bozotics/soccer2019/PCB/projects/maplemini/maplemini.png

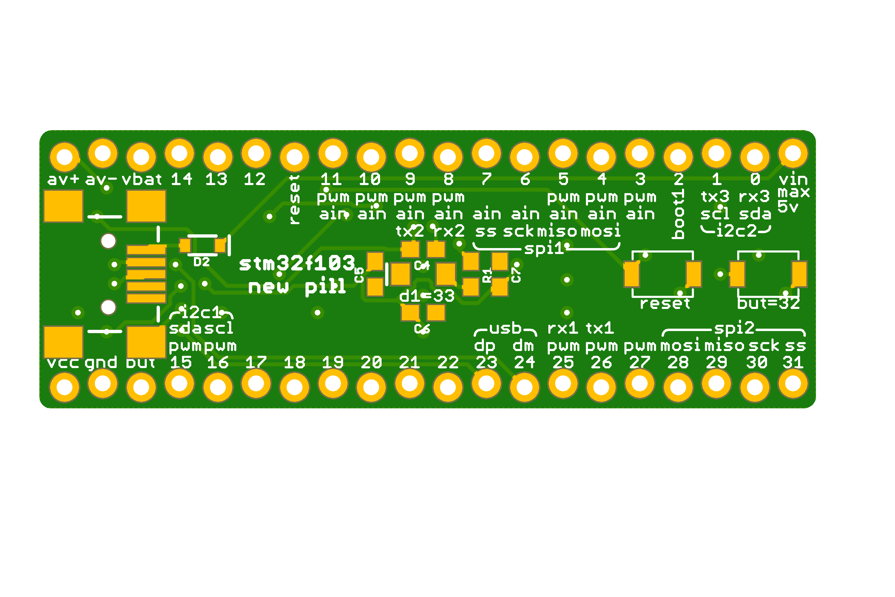
PCB/projects/maplemini/maplemini.png
