bozotics/soccer2019/PCB/projects/PCB2k19/PCB1.pdf

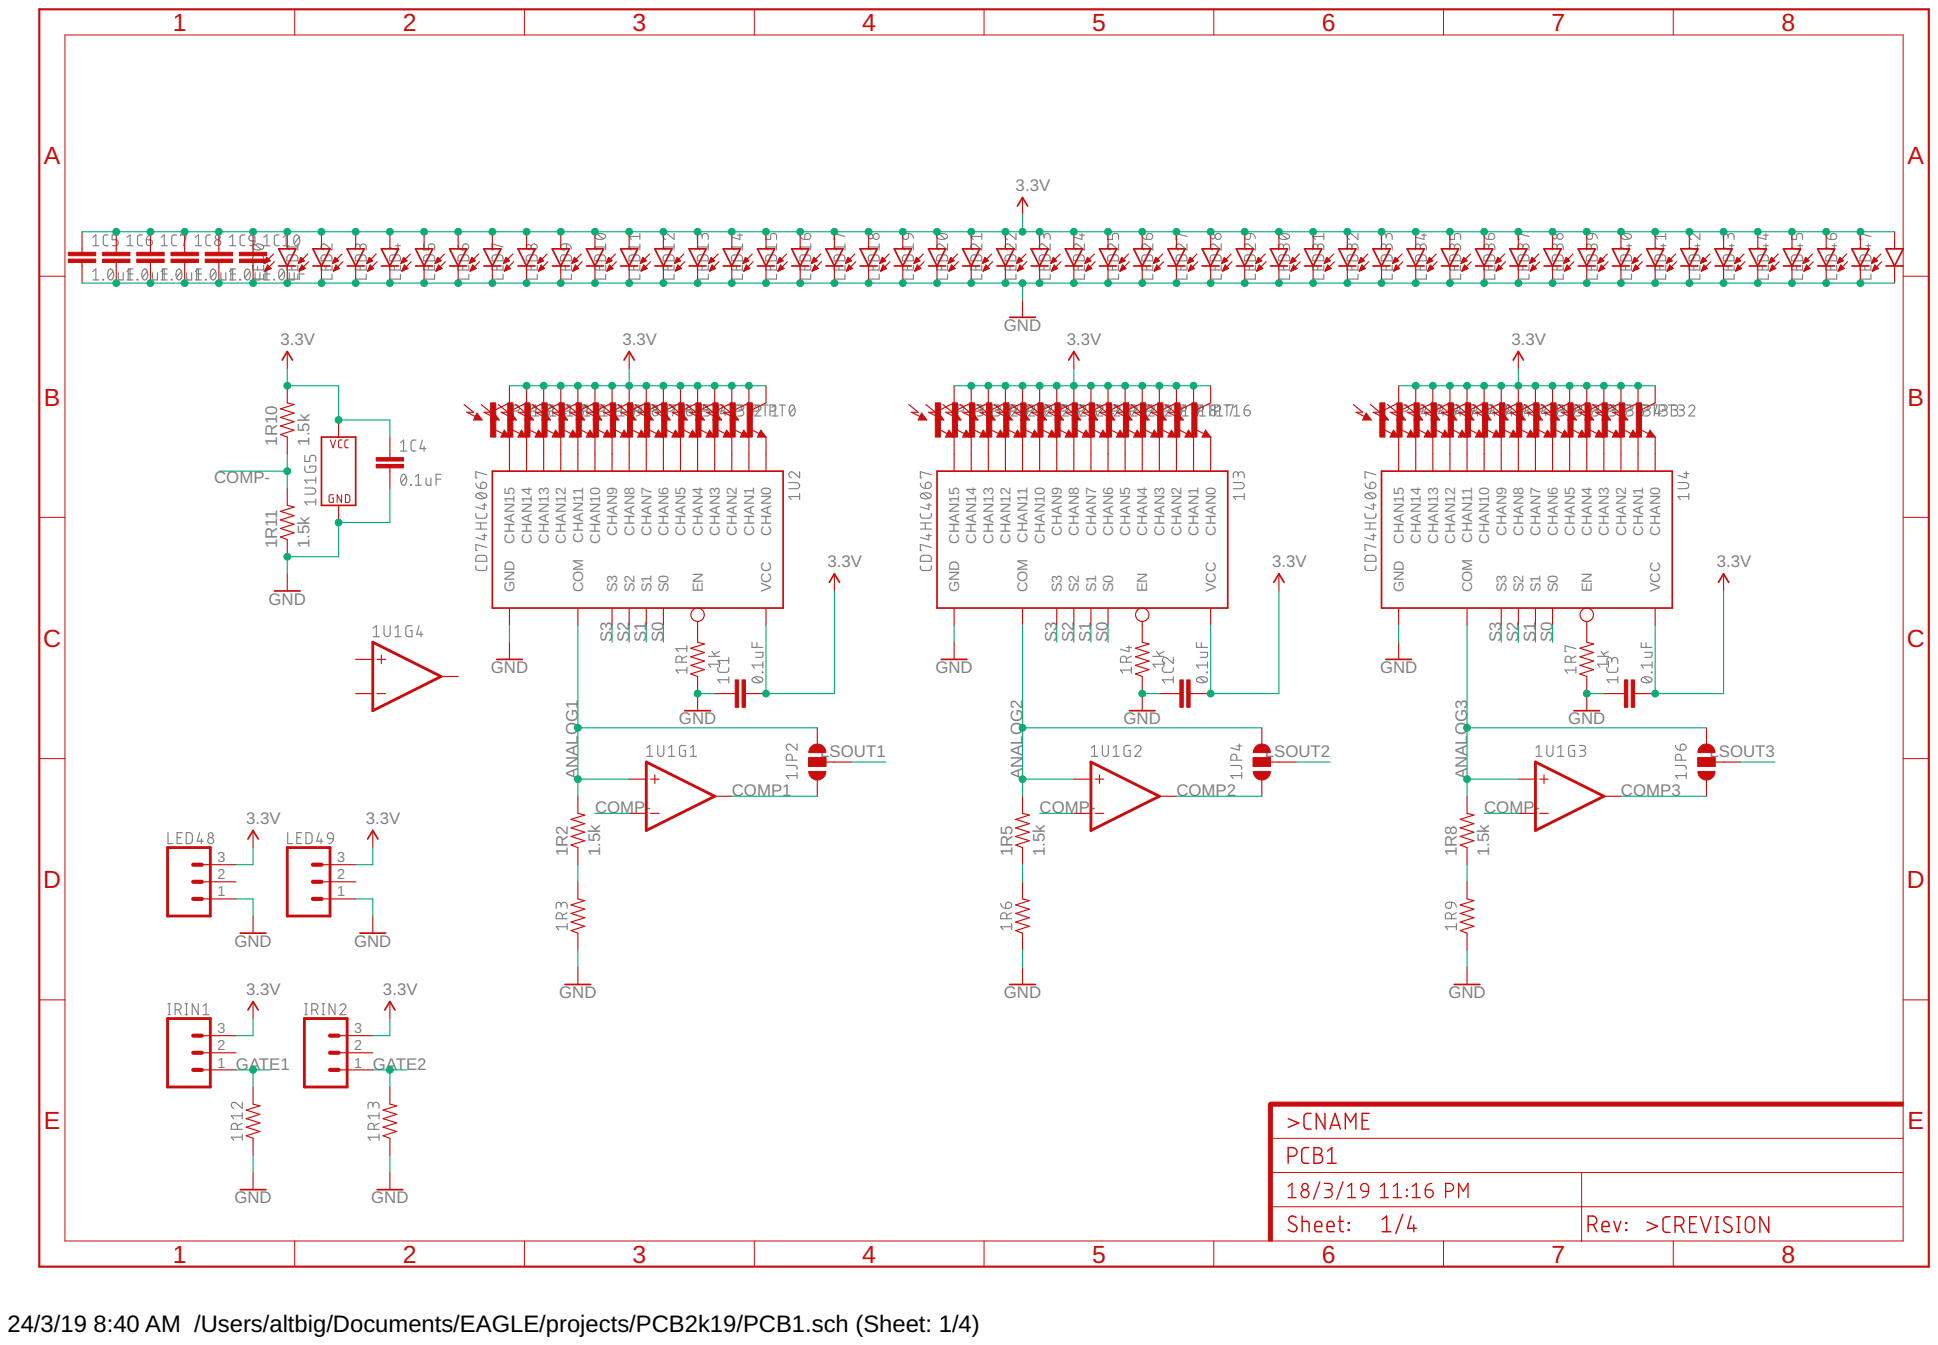
[picture p2: page 1]

24/3/19 8:40 AM /Users/altbig/Documents/EAGLE/projects/PCB2k19/PCB1.sch (Sheet: 1/4)

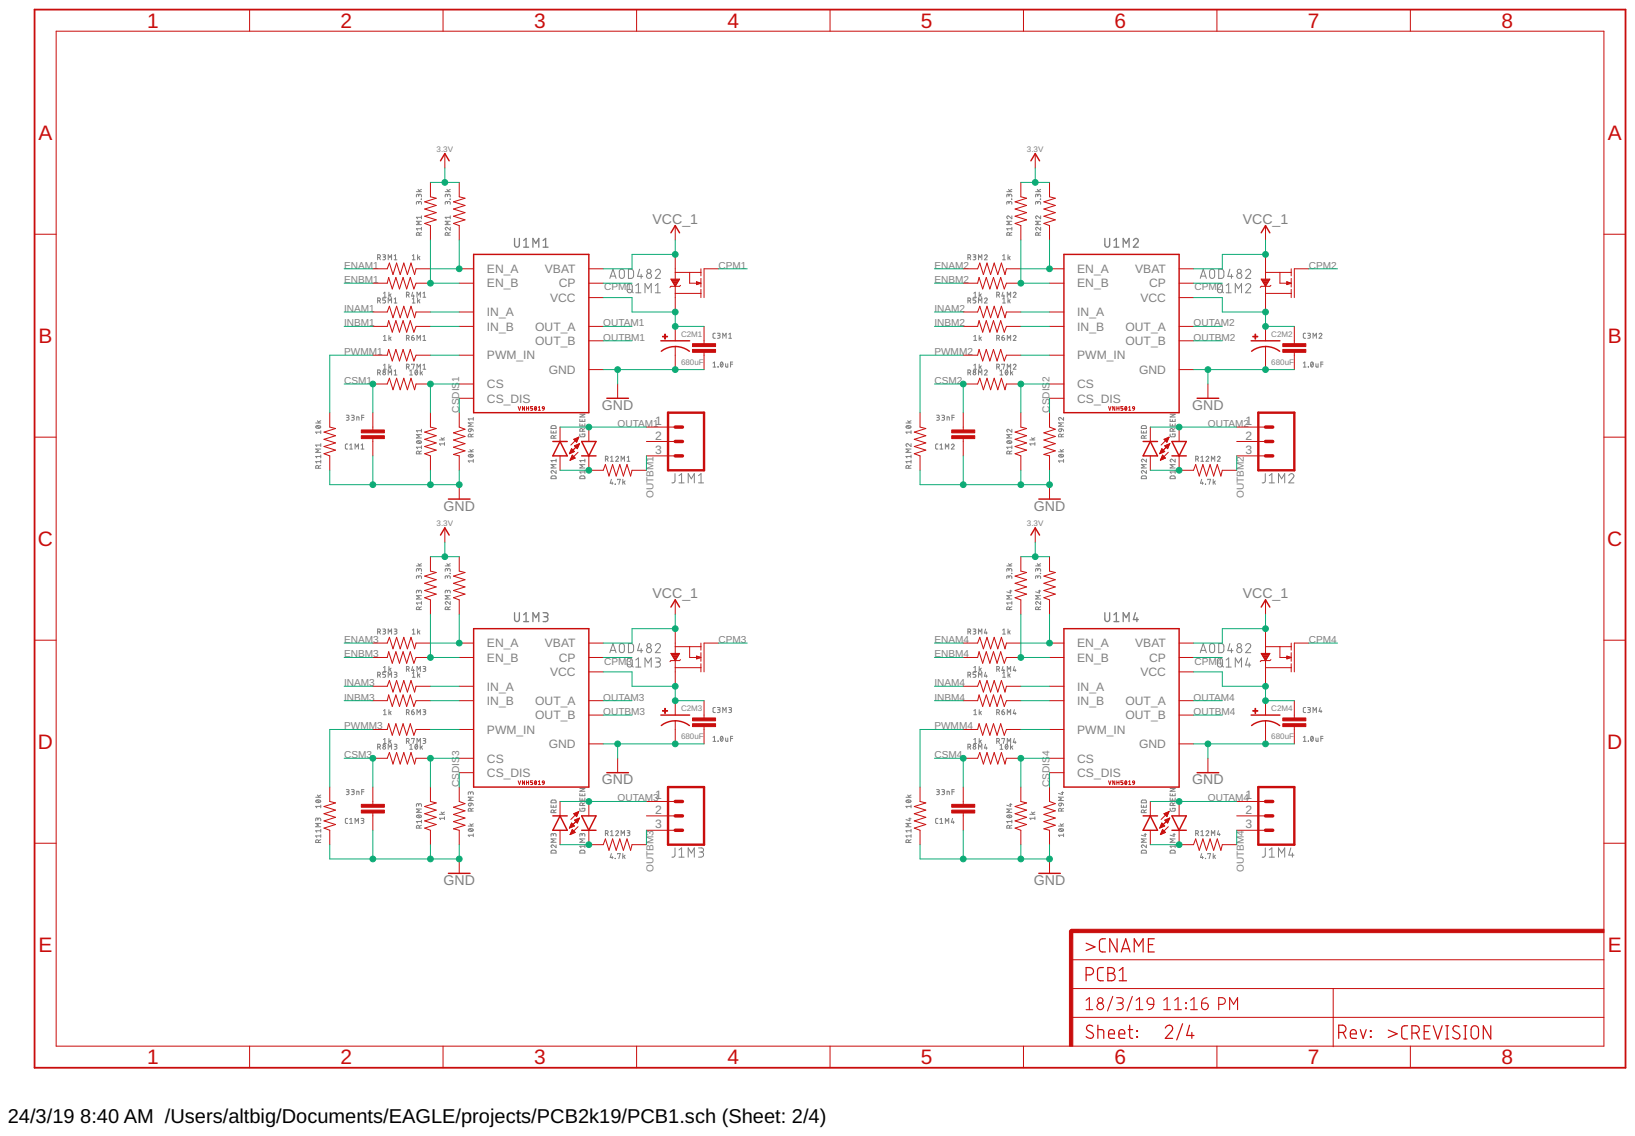
[picture p3: page 2]

24/3/19 8:40 AM /Users/altbig/Documents/EAGLE/projects/PCB2k19/PCB1.sch (Sheet: 2/4)

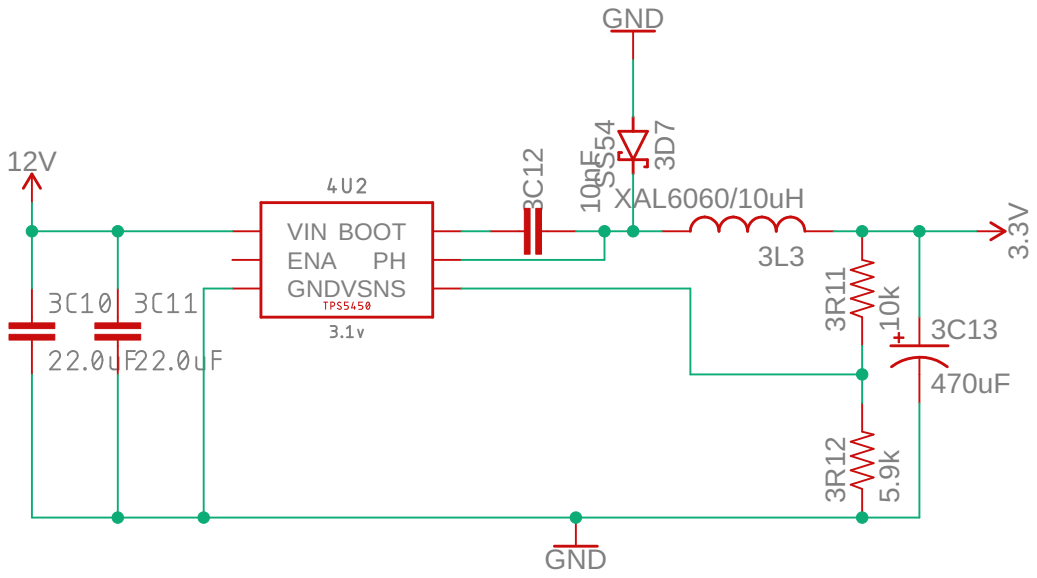
[picture p4: page 3]

24/3/19 8:40 AM /Users/altbig/Documents/EAGLE/projects/PCB2k19/PCB1.sch (Sheet: 3/4)

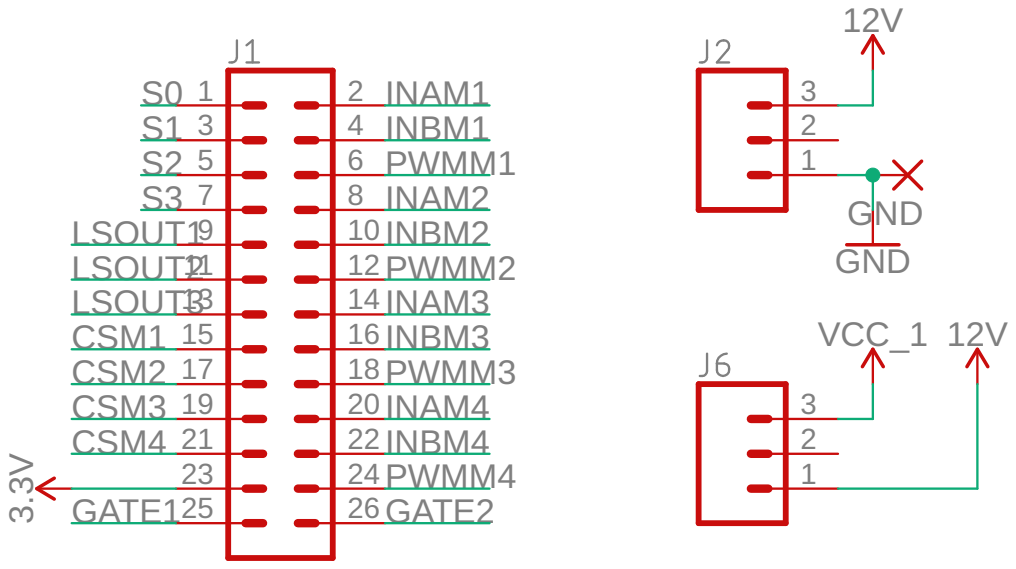
[picture p5: page 4]

24/3/19 8:40 AM /Users/altbig/Documents/EAGLE/projects/PCB2k19/PCB1.sch (Sheet: 4/4)
