bozotics/soccer2019/PCB/projects/PCB2k19/PCB2.pdf

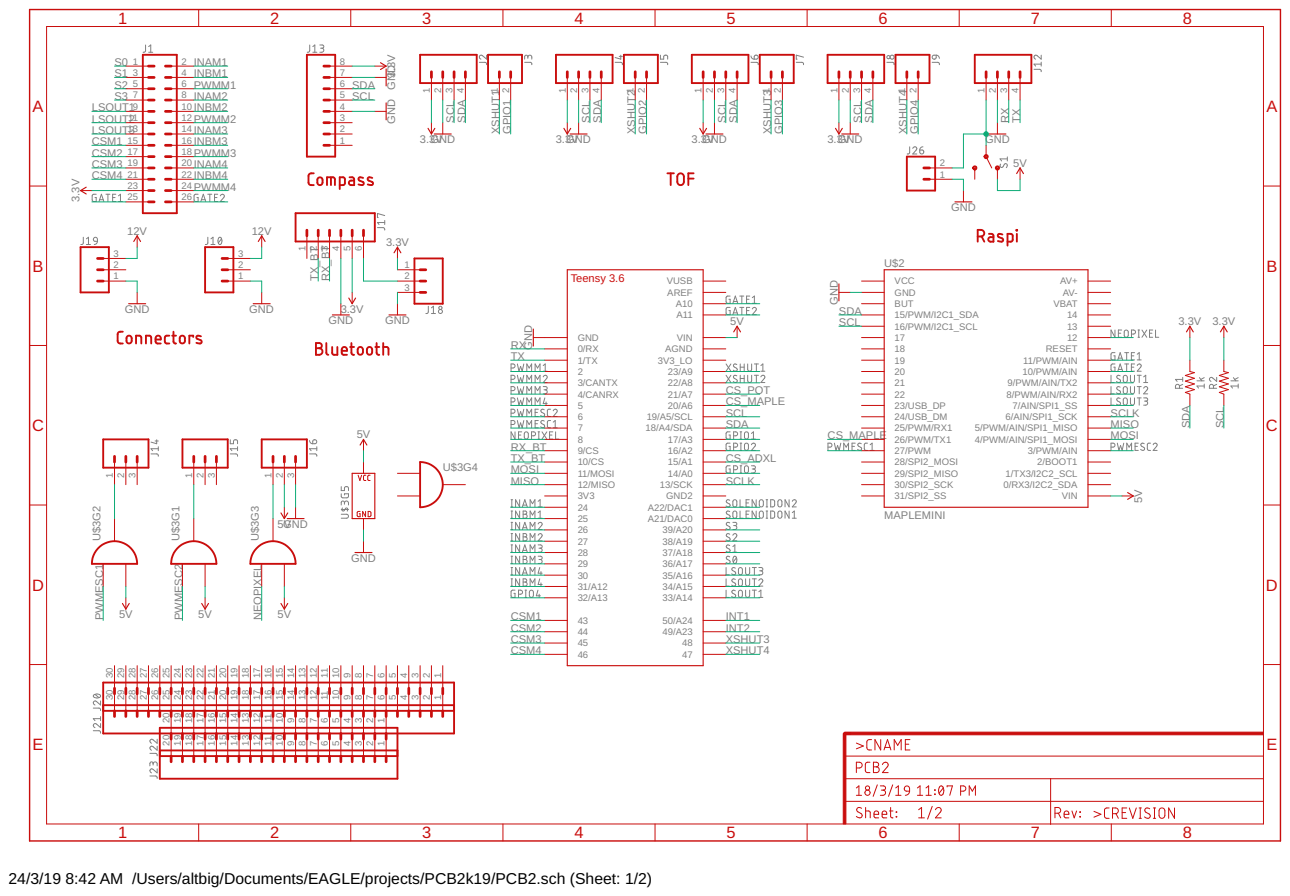
[picture p6: page 1]

11/PWM/AIN
10/PWM/AIN
9/PWM/AIN/TX2
8/PWM/AIN/RX2
7/AIN/SPI1_SS
6/AIN/SPI1_SCK
5/PWM/AIN/SPI1_MISO
4/PWM/AIN/SPI1_MOSI 3/PWM/AIN

24/3/19 8:42 AM /Users/altbig/Documents/EAGLE/projects/PCB2k19/PCB2.sch (Sheet: 1/2)

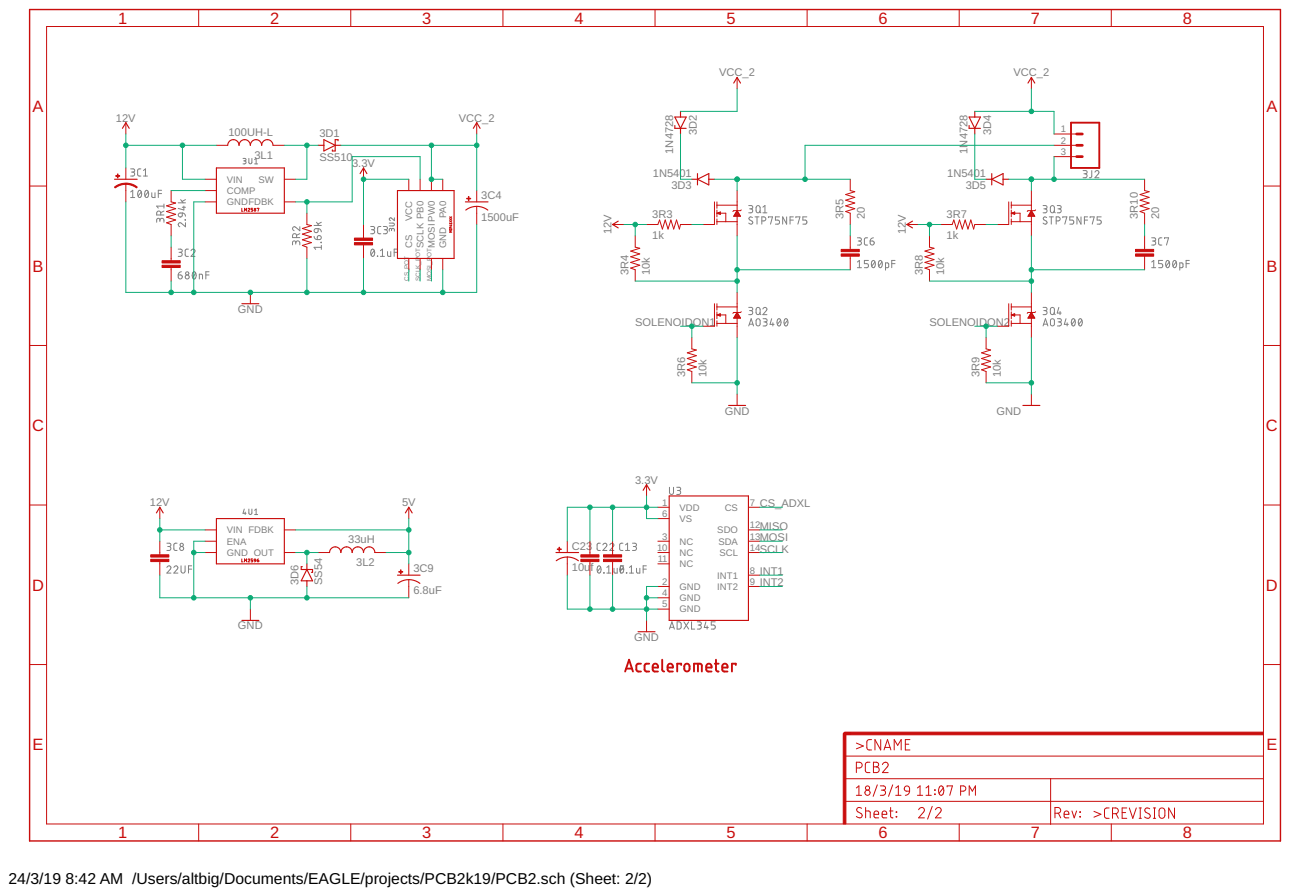
[picture p7: page 2]

SCLK MOSI GND PA0 PW0 PB0 VCC

ENA GND OUT VIN FDBK

24/3/19 8:42 AM /Users/altbig/Documents/EAGLE/projects/PCB2k19/PCB2.sch (Sheet: 2/2)
