bozotics/soccer2019/PCB/projects/maplemini/maplemini2layer.pdf

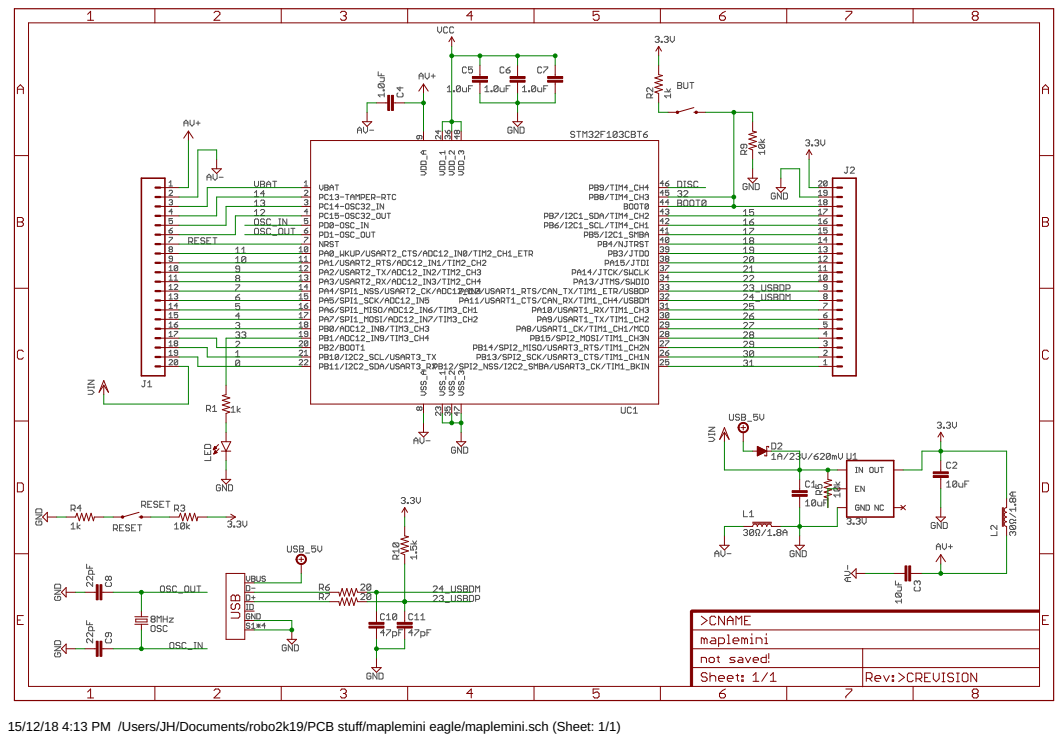
[picture p8: page 1]

15/12/18 4:13 PM /Users/JH/Documents/robo2k19/PCB stuff/maplemini eagle/maplemini.sch (Sheet: 1/1)
