bozotics/soccer2019/PCB/projects/PCB2k19/PCB2.brd

## EAGLE design PCB/projects/PCB2k19/PCB2.brd (2019-03-18)

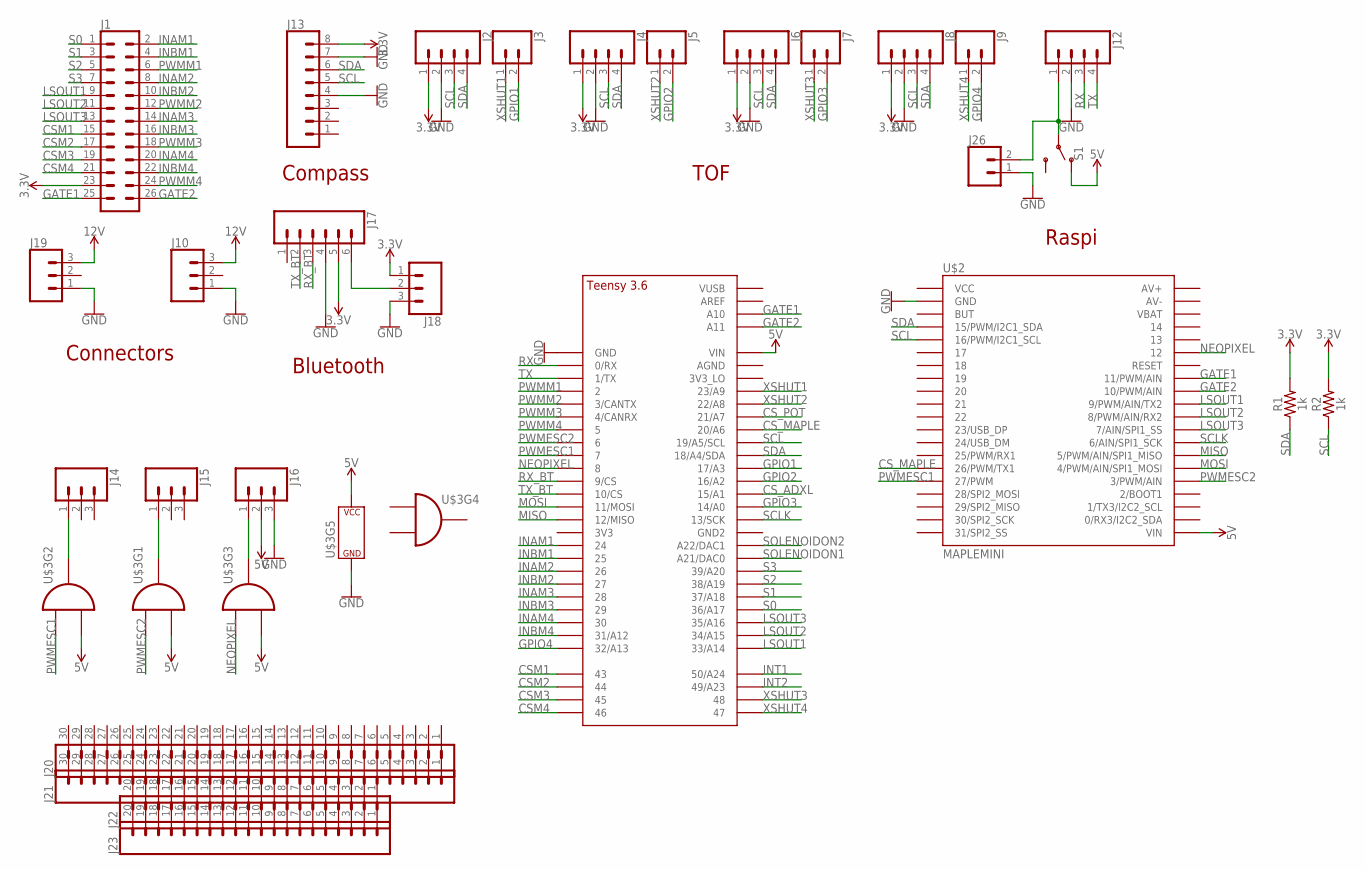
[picture p9: schematic PCB2.sch, sheet 1]

Parts:
J1: CONN_13X22X13; 2X13
J2, J4, J6, J8, J12: CONN_04LOCK; 1X04_LOCK
J3, J5, J7, J9, J26: CONN_02LOCK; 1X02_LOCK
J10, J19: CONN_03-SCREW-5MM; SCREWTERMINAL-5MM-3
J13: CONN_08LOCK; 1X08_LOCK
J14, J15, J16, J18: CONN_03LOCK; 1X03_LOCK
J17: CONN_06LOCK; 1X06_LOCK
J20, J21: CONN_30; 1X30
J22, J23: CONN_20; 1X20
R1, R2: 1k; 0603
S1: SWITCH-SPDT-PTH-11.6X4.0MM-LOCK; SWITCH_SPDT_PTH_11.6X4.0MM_LOCK
U$1: TEENSY_3.5/3.6_BASIC
U$2: MAPLEMINI; 20-DIP
U$3: 74HCT08; SOIC-14

Connections:
3.3V: J1.23, J2.1, J4.1, J6.1, J8.1, J13.8, J17.5, J18.1, R1.2, R2.2; also elsewhere on the board
5V: J16.2, S1.1 (O), U$1.VIN, U$2.21 (VIN), U$3.P2 (I1), U$3.P5 (I1), U$3.P10 (I1), U$3.P14 (P$V+); also elsewhere on the board
12V: J10.3, J19.3; also elsewhere on the board
CSM1: J1.15, U$1.43
CSM2: J1.17, U$1.44
CSM3: J1.19, U$1.45
CSM4: J1.21, U$1.46
CS_ADXL: U$1.15/A1; also elsewhere on the board
CS_MAPLE: U$1.20/A6, U$2.15 (26/PWM/TX1)
CS_POT: U$1.21/A7; also elsewhere on the board
GATE1: J1.25, U$1.A10, U$2.33 (11/PWM/AIN)
GATE2: J1.26, U$1.A11, U$2.32 (10/PWM/AIN)
GND: J2.2, J4.2, J6.2, J8.2, J10.1, J12.2, J13.4, J13.7, J16.3, J17.4, J18.3, J19.1, J26.1, U$1.GND, U$2.2 (GND), U$3.P7 (P$V-); also elsewhere on the board
GPIO1: J3.2, U$1.17/A3
GPIO2: J5.2, U$1.16/A2
GPIO3: J7.2, U$1.14/A0
GPIO4: J9.2, U$1.32/A13
INAM1: J1.2, U$1.24
INAM2: J1.8, U$1.26
INAM3: J1.14, U$1.28
INAM4: J1.20, U$1.30
INBM1: J1.4, U$1.25
INBM2: J1.10, U$1.27
INBM3: J1.16, U$1.29
INBM4: J1.22, U$1.31/A12
INT1: U$1.50/A24; also elsewhere on the board
INT2: U$1.49/A23; also elsewhere on the board
LSOUT1: J1.9, U$1.33/A14, U$2.31 (9/PWM/AIN/TX2)
LSOUT2: J1.11, U$1.34/A15, U$2.30 (8/PWM/AIN/RX2)
LSOUT3: J1.13, U$1.35/A16, U$2.29 (7/AIN/SPI1_SS)
MISO: U$1.12/MISO, U$2.27 (5/PWM/AIN/SPI1_MISO); also elsewhere on the board
MOSI: U$1.11/MOSI, U$2.26 (4/PWM/AIN/SPI1_MOSI); also elsewhere on the board
unnamed: J12.1, J26.2, S1.2
unnamed: J16.1, U$3.P8 (O)
unnamed: J14.1, U$3.P6 (O)
unnamed: J15.1, U$3.P3 (O)
unnamed: J17.6, J18.2
NEOPIXEL: U$1.8, U$2.35 (12), U$3.P9 (I0)
PWMESC1: U$1.7, U$2.16 (27/PWM), U$3.P4 (I0)
PWMESC2: U$1.6, U$2.25 (3/PWM/AIN), U$3.P1 (I0)
PWMM1: J1.6, U$1.2
PWMM2: J1.12, U$1.3/CANTX
PWMM3: J1.18, U$1.4/CANRX
PWMM4: J1.24, U$1.5
RX: J12.3, U$1.0/RX
RX_BT: J17.3, U$1.9/CS
S0: J1.1, U$1.36/A17
S1: J1.3, U$1.37/A18
S2: J1.5, U$1.38/A19
S3: J1.7, U$1.39/A20
SCL: J2.3, J4.3, J6.3, J8.3, J13.5, R2.1, U$1.19/A5/SCL, U$2.5 (16/PWM/I2C1_SCL)
SCLK: U$1.13/SCK, U$2.28 (6/AIN/SPI1_SCK); also elsewhere on the board
SDA: J2.4, J4.4, J6.4, J8.4, J13.6, R1.1, U$1.18/A4/SDA, U$2.4 (15/PWM/I2C1_SDA)
SOLENOIDON1: U$1.21/DAC0 (A21/DAC0); also elsewhere on the board
SOLENOIDON2: U$1.A22/DAC1; also elsewhere on the board
TX: J12.4, U$1.1/TX
TX_BT: J17.2, U$1.10/CS
XSHUT1: J3.1, U$1.23/A9
XSHUT2: J5.1, U$1.22/A8
XSHUT3: J7.1, U$1.48
XSHUT4: J9.1, U$1.47

Notes on the sheet:
Raspi
TOF
Compass
Connectors
Bluetooth

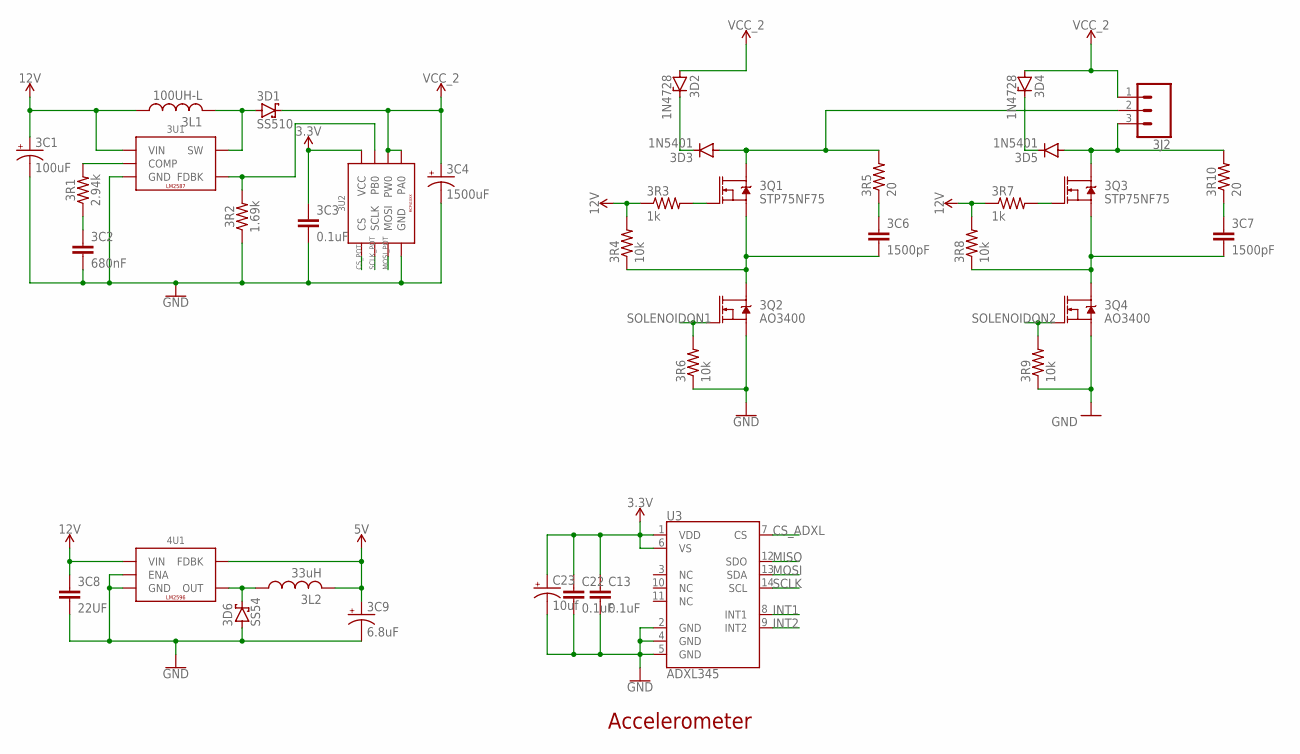
[picture p10: schematic PCB2.sch, sheet 2]

Parts:
3C1: 100uF; PANASONIC_D
3C2: 680nF; 0603
3C3: 0.1uF; 0603
3C4: 1500uF; 1000UF-CAP
3C6, 3C7: 1500pF; 0603
3C8: 22UF; 1210
3C9: 6.8uF; A/3216-18R
3D1: SS510; SMB
3D2, 3D4: 1N4728; DO41Z10
3D3, 3D5: 1N5401; DO201-15
3D6: SS54; SMB
3J2: CONN_03-SCREW-5MM; SCREWTERMINAL-5MM-3
3L1: 100UH-L
3L2: 33uH; 127
3Q1, 3Q3: STP75NF75; TO220V
3Q2, 3Q4: AO3400; SOT23-3
3R1: 2.94k; 0603
3R2: 1.69k; 0603
3R3, 3R7: 1k; 0603
3R4, 3R6, 3R8, 3R9: 10k; 0603
3R5, 3R10: 20; 0603
3U1: LM2587; TO-263
3U2: MCP41XXX; SOIC-8
4U1: LM2596; TO-263
C13, C22: 0.1uF; 0603
C23: 10uf; R/2012-12R
U3: ADXL345; LGA-14

Connections:
3.3V: 3C3.1, 3U2.8 (VCC), C13.1, C22.1, C23.+, U3.1 (VDD), U3.6 (VS); also elsewhere on the board
5V: 3C9.+, 3L2.2, 4U1.P4 (FDBK); also elsewhere on the board
12V: 3C1.+, 3C8.1, 3L1.P1 (1), 3R3.1, 3R4.2, 3R7.1, 3R8.2, 3U1.P5 (VIN), 4U1.P1 (VIN); also elsewhere on the board
CS_ADXL: U3.7 (CS); also elsewhere on the board
CS_POT: 3U2.1 (CS); also elsewhere on the board
GND: 3C1.-, 3C2.2, 3C3.2, 3C4.-, 3C8.2, 3C9.-, 3D6.A, 3Q2.2 (S), 3Q4.2 (S), 3R2.1, 3R6.1, 3R9.1, 3U1.P3 (GND), 3U2.4 (GND), 4U1.P3 (GND), 4U1.P5 (ENA), 4U1.TAB (GND), C13.2, C22.2, C23.-, U3.2 (GND), U3.4 (GND), U3.5 (GND); also elsewhere on the board
INT1: U3.8 (INT1); also elsewhere on the board
INT2: U3.9 (INT2); also elsewhere on the board
MISO: U3.12 (SDO); also elsewhere on the board
MOSI: U3.13 (SDA); also elsewhere on the board
MOSI_POT: 3U2.3 (MOSI)
unnamed: 3D1.A, 3L1.P2 (2), 3U1.P4 (SW)
unnamed: 3C6.2, 3Q1.3 (S), 3Q2.3 (D), 3R4.1
unnamed: 3R1.2, 3U1.P1 (COMP)
unnamed: 3C2.1, 3R1.1
unnamed: 3Q1.1 (G), 3R3.2
unnamed: 3D2.C, 3D3.C
unnamed: 3C6.1, 3R5.1
unnamed: 3C7.2, 3Q3.3 (S), 3Q4.3 (D), 3R8.1
unnamed: 3Q3.1 (G), 3R7.2
unnamed: 3D4.C, 3D5.C
unnamed: 3C7.1, 3R10.1
unnamed: 3D6.C, 3L2.1, 4U1.P2 (OUT)
unnamed: 3R2.2, 3U1.P2 (FDBK), 3U2.7 (PB0)
SCLK: U3.14 (SCL); also elsewhere on the board
SCLK_POT: 3U2.2 (SCLK)
SOLENOID-: 3D3.A, 3J2.2, 3Q1.2 (D), 3R5.2
SOLENOID-1: 3D5.A, 3J2.3, 3Q3.2 (D), 3R10.2
SOLENOIDON1: 3Q2.1 (G), 3R6.2; also elsewhere on the board
SOLENOIDON2: 3Q4.1 (G), 3R9.2; also elsewhere on the board
VCC_2: 3C4.+, 3D1.C, 3D2.A, 3D4.A, 3J2.1, 3U2.5 (PA0), 3U2.6 (PW0)

Notes on the sheet:
Accelerometer

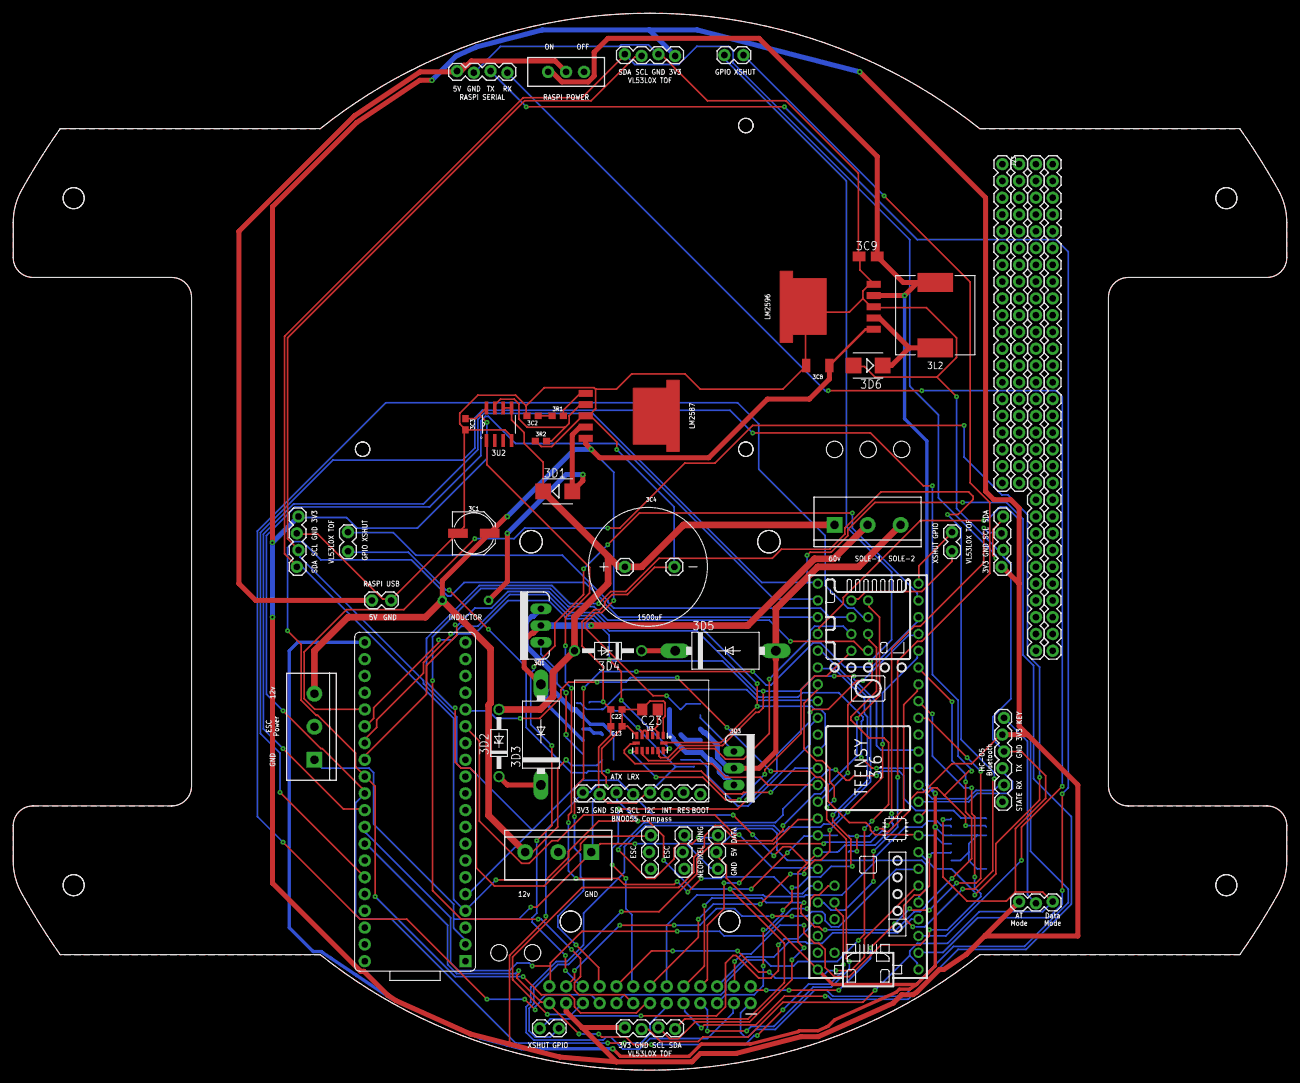
[picture p11: board PCB2.brd from above]

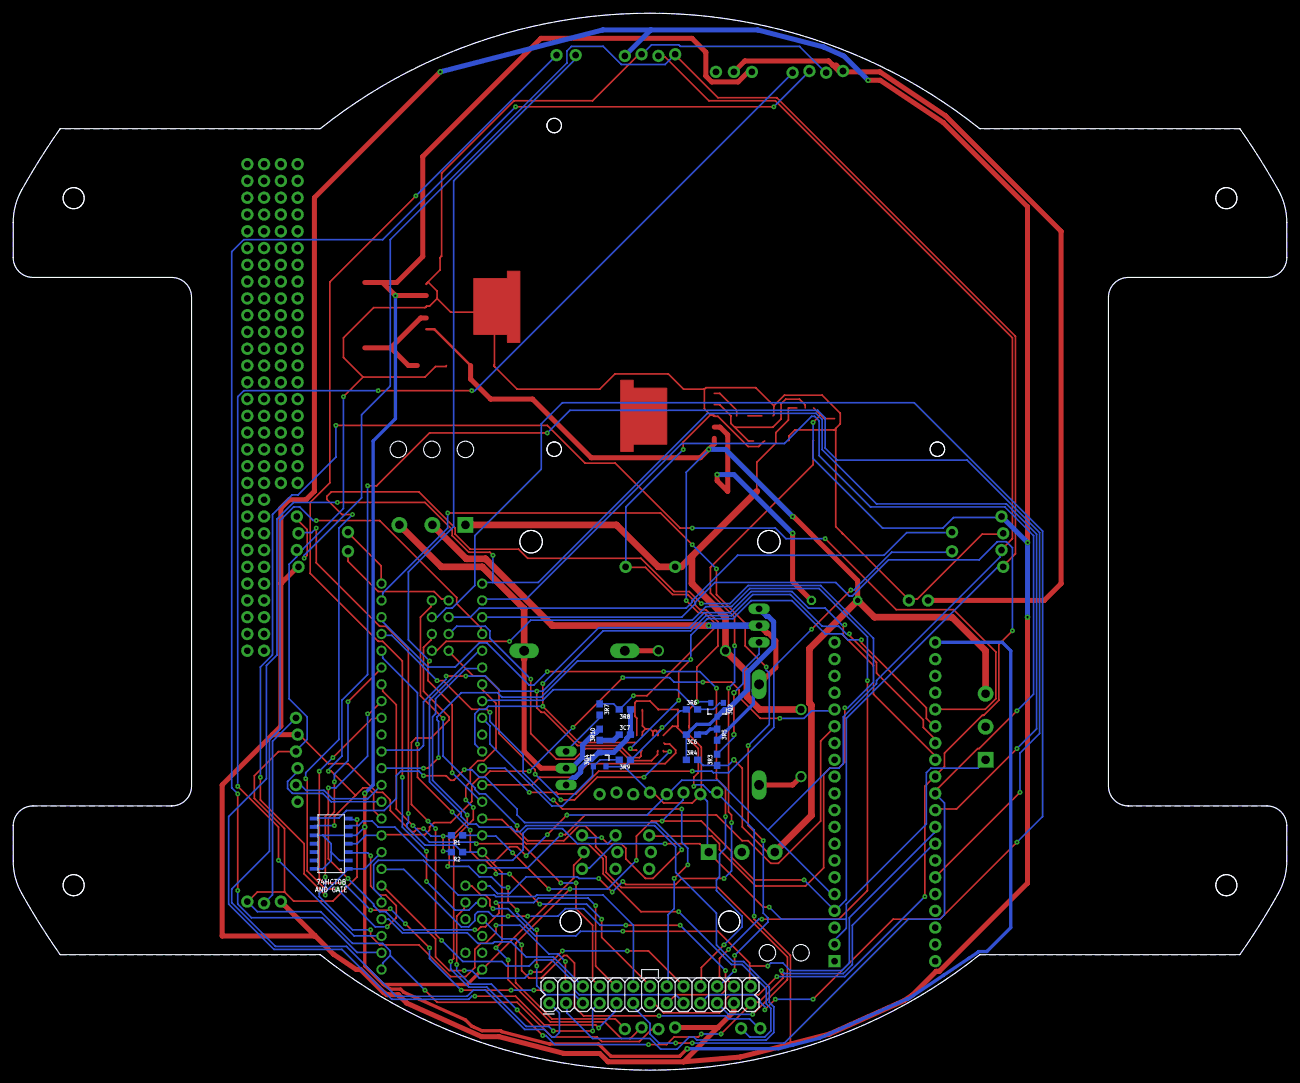
[picture p12: board PCB2.brd from below]

Board: 2 copper layers, 192.8 x 160.0 mm, 67 parts (16 on the bottom side), 77 nets.
