bozotics/soccer2019/PCB/projects/PCB2k19/PCB1.brd

## EAGLE design PCB/projects/PCB2k19/PCB1.brd (2019-03-18)

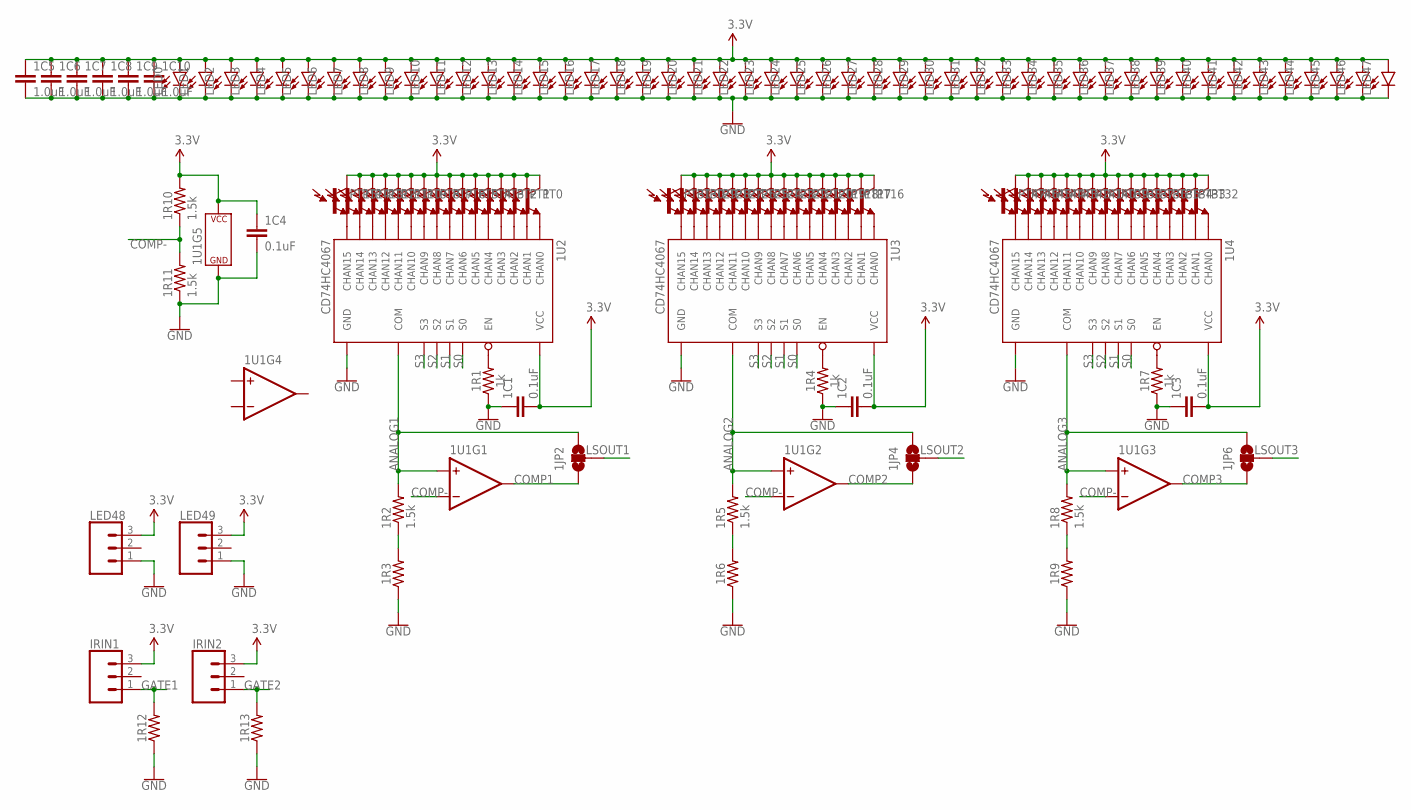
[picture p13: schematic PCB1.sch, sheet 1, Light Sensor]

Parts:
1C1, 1C2, 1C3, 1C4: 0.1uF; 0603
1C5, 1C6, 1C7, 1C8, 1C9, 1C10: 1.0uF; 0603
1JP2, 1JP4, 1JP6: JUMPER-SMT_3_NO_NO_SILK; SMT-JUMPER_3_0-NO_TRACE_NO-SILK
1R1, 1R4, 1R7: 1k; 0603
1R2, 1R5, 1R8, 1R10, 1R11: 1.5k; 0603
1R3, 1R6, 1R9, 1R12, 1R13: 0603
1U1: LM339; SOIC-14
1U2, 1U3, 1U4: CD74HC4067; SOIC-24
IRIN1, IRIN2: CONN_03; 1X03
LED0, LED1, LED2, LED3, LED4, LED5, LED6, LED7, LED8, LED9, LED10, LED11, LED12, LED13, LED14, LED15, LED16, LED17, LED18, LED19, LED20, LED21, LED22, LED23, LED24, LED25, LED26, LED27, LED28, LED29, LED30, LED31, LED32, LED33, LED34, LED35, LED36, LED37, LED38, LED39, LED40, LED41, LED42, LED43, LED44, LED45, LED46, LED47: 3528LED; 3528
LED48, LED49: CONN_03; 1X03
PT0, PT1, PT2, PT3, PT4, PT5, PT6, PT7, PT8, PT9, PT10, PT11, PT12, PT13, PT14, PT15, PT16, PT17, PT18, PT19, PT20, PT21, PT22, PT23, PT24, PT25, PT26, PT27, PT28, PT29, PT30, PT31, PT32, PT33, PT34, PT35, PT36, PT37, PT38, PT39, PT40, PT41, PT42, PT43, PT44, PT45, PT46, PT47: TEMT6000

Connections:
3.3V: 1C1.2, 1C2.2, 1C3.2, 1C4.1, 1C5.1, 1C6.1, 1C7.1, 1C8.1, 1C9.1, 1C10.1, 1R10.2, 1U1.P3 (P$V+), 1U2.P24 (VCC), 1U3.P24 (VCC), 1U4.P24 (VCC), IRIN1.3, IRIN2.3, LED0.A, LED1.A, LED2.A, LED3.A, LED4.A, LED5.A, LED6.A, LED7.A, LED8.A, LED9.A, LED10.A, LED11.A, LED12.A, LED13.A, LED14.A, LED15.A, LED16.A, LED17.A, LED18.A, LED19.A, LED20.A, LED21.A, LED22.A, LED23.A, LED24.A, LED25.A, LED26.A, LED27.A, LED28.A, LED29.A, LED30.A, LED31.A, LED32.A, LED33.A, LED34.A, LED35.A, LED36.A, LED37.A, LED38.A, LED39.A, LED40.A, LED41.A, LED42.A, LED43.A, LED44.A, LED45.A, LED46.A, LED47.A, LED48.3, LED49.3, PT0.COLLECTOR (C1), PT1.COLLECTOR (C1), PT2.COLLECTOR (C1), PT3.COLLECTOR (C1), PT4.COLLECTOR (C1), PT5.COLLECTOR (C1), PT6.COLLECTOR (C1), PT7.COLLECTOR (C1), PT8.COLLECTOR (C1), PT9.COLLECTOR (C1), PT10.COLLECTOR (C1), PT11.COLLECTOR (C1), PT12.COLLECTOR (C1), PT13.COLLECTOR (C1), PT14.COLLECTOR (C1), PT15.COLLECTOR (C1), PT16.COLLECTOR (C1), PT17.COLLECTOR (C1), PT18.COLLECTOR (C1), PT19.COLLECTOR (C1), PT20.COLLECTOR (C1), PT21.COLLECTOR (C1), PT22.COLLECTOR (C1), PT23.COLLECTOR (C1), PT24.COLLECTOR (C1), PT25.COLLECTOR (C1), PT26.COLLECTOR (C1), PT27.COLLECTOR (C1), PT28.COLLECTOR (C1), PT29.COLLECTOR (C1), PT30.COLLECTOR (C1), PT31.COLLECTOR (C1), PT32.COLLECTOR (C1), PT33.COLLECTOR (C1), PT34.COLLECTOR (C1), PT35.COLLECTOR (C1), PT36.COLLECTOR (C1), PT37.COLLECTOR (C1), PT38.COLLECTOR (C1), PT39.COLLECTOR (C1), PT40.COLLECTOR (C1), PT41.COLLECTOR (C1), PT42.COLLECTOR (C1), PT43.COLLECTOR (C1), PT44.COLLECTOR (C1), PT45.COLLECTOR (C1), PT46.COLLECTOR (C1), PT47.COLLECTOR (C1); also elsewhere on the board
ANALOG1: 1JP2.3, 1R2.2, 1U1.P5 (+IN), 1U2.P1 (COM)
ANALOG2: 1JP4.3, 1R5.2, 1U1.P7 (+IN), 1U3.P1 (COM)
ANALOG3: 1JP6.3, 1R8.2, 1U1.P9 (+IN), 1U4.P1 (COM)
COMP1: 1JP2.1, 1U1.P2 (OUT)
COMP2: 1JP4.1, 1U1.P1 (OUT)
COMP3: 1JP6.1, 1U1.P14 (OUT)
COMP-: 1R10.1, 1R11.2, 1U1.P4 (-IN), 1U1.P6 (-IN), 1U1.P8 (-IN)
GATE1: 1R12.2, IRIN1.1; also elsewhere on the board
GATE2: 1R13.2, IRIN2.1; also elsewhere on the board
GND: 1C1.1, 1C2.1, 1C3.1, 1C4.2, 1C5.2, 1C6.2, 1C7.2, 1C8.2, 1C9.2, 1C10.2, 1R1.1, 1R3.1, 1R4.1, 1R6.1, 1R7.1, 1R9.1, 1R11.1, 1R12.1, 1R13.1, 1U1.P12 (P$V-), 1U2.P12 (GND), 1U3.P12 (GND), 1U4.P12 (GND), LED0.C, LED1.C, LED2.C, LED3.C, LED4.C, LED5.C, LED6.C, LED7.C, LED8.C, LED9.C, LED10.C, LED11.C, LED12.C, LED13.C, LED14.C, LED15.C, LED16.C, LED17.C, LED18.C, LED19.C, LED20.C, LED21.C, LED22.C, LED23.C, LED24.C, LED25.C, LED26.C, LED27.C, LED28.C, LED29.C, LED30.C, LED31.C, LED32.C, LED33.C, LED34.C, LED35.C, LED36.C, LED37.C, LED38.C, LED39.C, LED40.C, LED41.C, LED42.C, LED43.C, LED44.C, LED45.C, LED46.C, LED47.C, LED48.1, LED49.1; also elsewhere on the board
LSOUT1: 1JP2.2; also elsewhere on the board
LSOUT2: 1JP4.2; also elsewhere on the board
LSOUT3: 1JP6.2; also elsewhere on the board
unnamed: 1U2.P9 (CHAN0), PT0.EMITTER (E1)
unnamed: 1R1.2, 1U2.P15 (EN)
unnamed: 1U2.P8 (CHAN1), PT1.EMITTER (E1)
unnamed: 1U2.P7 (CHAN2), PT2.EMITTER (E1)
unnamed: 1U2.P6 (CHAN3), PT3.EMITTER (E1)
unnamed: 1U2.P5 (CHAN4), PT4.EMITTER (E1)
unnamed: 1U2.P4 (CHAN5), PT5.EMITTER (E1)
unnamed: 1U2.P3 (CHAN6), PT6.EMITTER (E1)
unnamed: 1U2.P2 (CHAN7), PT7.EMITTER (E1)
unnamed: 1U2.P23 (CHAN8), PT8.EMITTER (E1)
unnamed: 1U2.P22 (CHAN9), PT9.EMITTER (E1)
unnamed: 1U2.P21 (CHAN10), PT10.EMITTER (E1)
unnamed: 1U2.P20 (CHAN11), PT11.EMITTER (E1)
unnamed: 1U2.P19 (CHAN12), PT12.EMITTER (E1)
unnamed: 1U2.P18 (CHAN13), PT13.EMITTER (E1)
unnamed: 1U2.P17 (CHAN14), PT14.EMITTER (E1)
unnamed: 1U2.P16 (CHAN15), PT15.EMITTER (E1)
unnamed: 1R4.2, 1U3.P15 (EN)
unnamed: 1R2.1, 1R3.2
unnamed: 1U3.P9 (CHAN0), PT16.EMITTER (E1)
unnamed: 1U3.P8 (CHAN1), PT17.EMITTER (E1)
unnamed: 1R5.1, 1R6.2
unnamed: 1U3.P7 (CHAN2), PT18.EMITTER (E1)
unnamed: 1U3.P6 (CHAN3), PT19.EMITTER (E1)
unnamed: 1U3.P5 (CHAN4), PT20.EMITTER (E1)
unnamed: 1U3.P4 (CHAN5), PT21.EMITTER (E1)
unnamed: 1U3.P3 (CHAN6), PT22.EMITTER (E1)
unnamed: 1U3.P2 (CHAN7), PT23.EMITTER (E1)
unnamed: 1U3.P23 (CHAN8), PT24.EMITTER (E1)
unnamed: 1U3.P22 (CHAN9), PT25.EMITTER (E1)
unnamed: 1U3.P21 (CHAN10), PT26.EMITTER (E1)
unnamed: 1U3.P20 (CHAN11), PT27.EMITTER (E1)
unnamed: 1U3.P19 (CHAN12), PT28.EMITTER (E1)
unnamed: 1U3.P18 (CHAN13), PT29.EMITTER (E1)
unnamed: 1U3.P17 (CHAN14), PT30.EMITTER (E1)
unnamed: 1U3.P16 (CHAN15), PT31.EMITTER (E1)
unnamed: 1U4.P9 (CHAN0), PT32.EMITTER (E1)
unnamed: 1U4.P8 (CHAN1), PT33.EMITTER (E1)
unnamed: 1R7.2, 1U4.P15 (EN)
unnamed: 1R8.1, 1R9.2
unnamed: 1U4.P7 (CHAN2), PT34.EMITTER (E1)
unnamed: 1U4.P6 (CHAN3), PT35.EMITTER (E1)
unnamed: 1U4.P5 (CHAN4), PT36.EMITTER (E1)
unnamed: 1U4.P4 (CHAN5), PT37.EMITTER (E1)
unnamed: 1U4.P3 (CHAN6), PT38.EMITTER (E1)
unnamed: 1U4.P2 (CHAN7), PT39.EMITTER (E1)
unnamed: 1U4.P23 (CHAN8), PT40.EMITTER (E1)
unnamed: 1U4.P22 (CHAN9), PT41.EMITTER (E1)
unnamed: 1U4.P21 (CHAN10), PT42.EMITTER (E1)
unnamed: 1U4.P20 (CHAN11), PT43.EMITTER (E1)
unnamed: 1U4.P19 (CHAN12), PT44.EMITTER (E1)
unnamed: 1U4.P18 (CHAN13), PT45.EMITTER (E1)
unnamed: 1U4.P17 (CHAN14), PT46.EMITTER (E1)
unnamed: 1U4.P16 (CHAN15), PT47.EMITTER (E1)
S0: 1U2.P10 (S0), 1U3.P10 (S0), 1U4.P10 (S0); also elsewhere on the board
S1: 1U2.P11 (S1), 1U3.P11 (S1), 1U4.P11 (S1); also elsewhere on the board
S2: 1U2.P14 (S2), 1U3.P14 (S2), 1U4.P14 (S2); also elsewhere on the board
S3: 1U2.P13 (S3), 1U3.P13 (S3), 1U4.P13 (S3); also elsewhere on the board

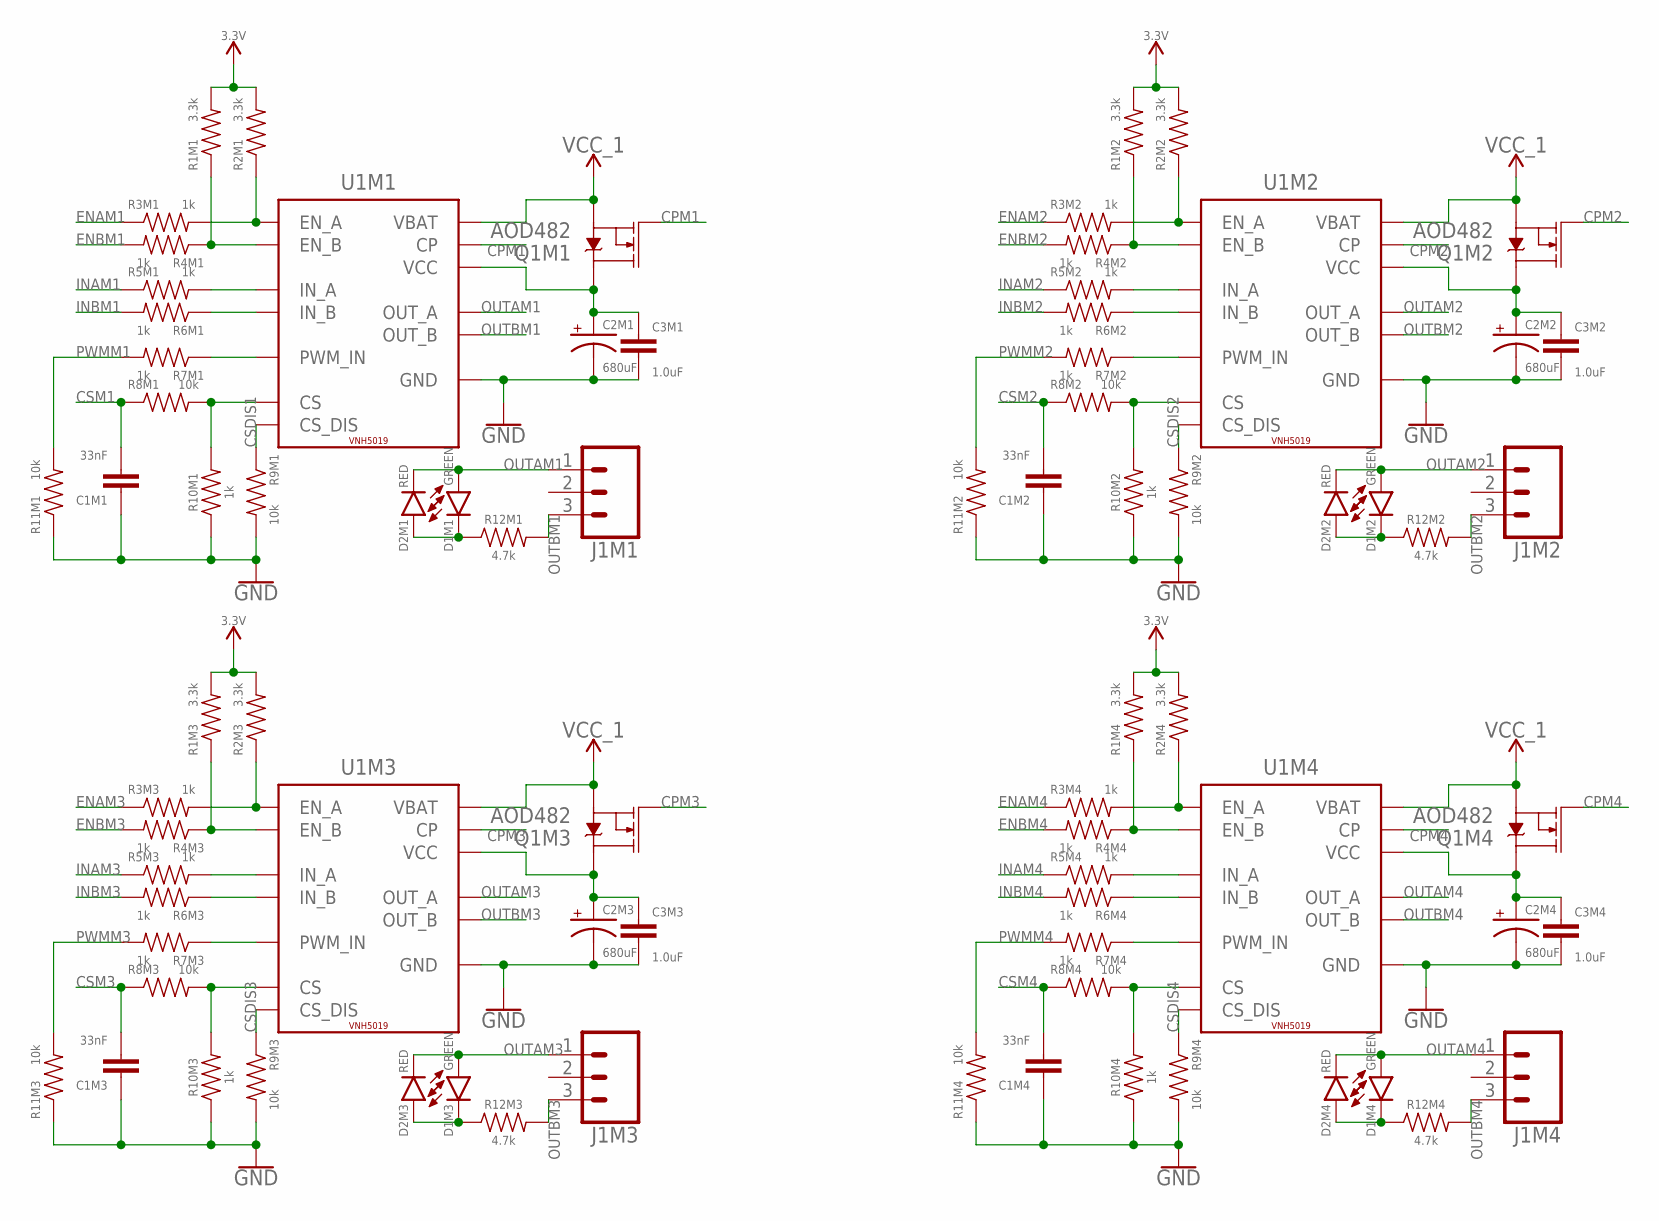
[picture p14: schematic PCB1.sch, sheet 2, Motor Driver]

Parts:
C1M1, C1M2, C1M3, C1M4: 33nF; 0603
C2M1, C2M2, C2M3, C2M4: 680uF; E3,5-8
C3M1, C3M2, C3M3, C3M4: 1.0uF; 0603
D1M1, D1M2, D1M3, D1M4: GREEN; LED-0603
D2M1, D2M2, D2M3, D2M4: RED; LED-0603
J1M1, J1M2, J1M3, J1M4: CONN_03-SCREW-5MM; SCREWTERMINAL-5MM-3
Q1M1, Q1M2, Q1M3, Q1M4: AOD482; DPAK
R1M1, R1M2, R1M3, R1M4, R2M1, R2M2, R2M3, R2M4: 3.3k; 0603
R3M1, R3M2, R3M3, R3M4, R4M1, R4M2, R4M3, R4M4, R5M1, R5M2, R5M3, R5M4, R6M1, R6M2, R6M3, R6M4, R7M1, R7M2, R7M3, R7M4, R10M1, R10M2, R10M3, R10M4: 1k; 0603
R8M1, R8M2, R8M3, R8M4, R9M1, R9M2, R9M3, R9M4, R11M1, R11M2, R11M3, R11M4: 10k; 0603
R12M1, R12M2, R12M3, R12M4: 4.7k; 0603
U1M1, U1M2, U1M3, U1M4: VNH5019; POWERSO-30

Connections:
3.3V: R1M1.2, R1M2.2, R1M3.2, R1M4.2, R2M1.2, R2M2.2, R2M3.2, R2M4.2; also elsewhere on the board
CPM1: Q1M1.1 (G), U1M1.P11 (CP)
CPM2: Q1M2.1 (G), U1M2.P11 (CP)
CPM3: Q1M3.1 (G), U1M3.P11 (CP)
CPM4: Q1M4.1 (G), U1M4.P11 (CP)
CSDIS1: R9M1.1, U1M1.P6 (CS_DIS)
CSDIS2: R9M2.1, U1M2.P6 (CS_DIS)
CSDIS3: R9M3.1, U1M3.P6 (CS_DIS)
CSDIS4: R9M4.1, U1M4.P6 (CS_DIS)
CSM1: C1M1.2, R8M1.1; also elsewhere on the board
CSM2: C1M2.2, R8M2.1; also elsewhere on the board
CSM3: C1M3.2, R8M3.1; also elsewhere on the board
CSM4: C1M4.2, R8M4.1; also elsewhere on the board
ENAM1: R3M1.1
ENAM2: R3M2.1
ENAM3: R3M3.1
ENAM4: R3M4.1
ENBM1: R4M1.2
ENBM2: R4M2.2
ENBM3: R4M3.2
ENBM4: R4M4.2
GND: C1M1.1, C1M2.1, C1M3.1, C1M4.1, C2M1.-, C2M2.-, C2M3.-, C2M4.-, C3M1.2, C3M2.2, C3M3.2, C3M4.2, R9M1.2, R9M2.2, R9M3.2, R9M4.2, R10M1.1, R10M2.1, R10M3.1, R10M4.1, R11M1.1, R11M2.1, R11M3.1, R11M4.1, U1M1.P18 (GND), U1M1.P19 (GND), U1M1.P20 (GND), U1M1.P26 (GND), U1M1.P27 (GND), U1M1.P28 (GND), U1M2.P18 (GND), U1M2.P19 (GND), U1M2.P20 (GND), U1M2.P26 (GND), U1M2.P27 (GND), U1M2.P28 (GND), U1M3.P18 (GND), U1M3.P19 (GND), U1M3.P20 (GND), U1M3.P26 (GND), U1M3.P27 (GND), U1M3.P28 (GND), U1M4.P18 (GND), U1M4.P19 (GND), U1M4.P20 (GND), U1M4.P26 (GND), U1M4.P27 (GND), U1M4.P28 (GND); also elsewhere on the board
INAM1: R5M1.1; also elsewhere on the board
INAM2: R5M2.1; also elsewhere on the board
INAM3: R5M3.1; also elsewhere on the board
INAM4: R5M4.1; also elsewhere on the board
INBM1: R6M1.2; also elsewhere on the board
INBM2: R6M2.2; also elsewhere on the board
INBM3: R6M3.2; also elsewhere on the board
INBM4: R6M4.2; also elsewhere on the board
unnamed: R2M1.1, R3M1.2, U1M1.P5 (EN_A)
unnamed: C2M1.+, C3M1.1, Q1M1.4 (D), U1M1.P3 (VCC), U1M1.P13 (VCC), U1M1.P23 (VCC), U1M1.SLUG1 (VCC)
unnamed: R1M1.1, R4M1.1, U1M1.P9 (EN_B)
unnamed: R6M1.1, U1M1.P10 (IN_B)
unnamed: R5M1.2, U1M1.P4 (IN_A)
unnamed: R8M1.2, R10M1.2, U1M1.P8 (CS)
unnamed: R7M1.1, U1M1.P7 (PWM_IN)
unnamed: C2M2.+, C3M2.1, Q1M2.4 (D), U1M2.P3 (VCC), U1M2.P13 (VCC), U1M2.P23 (VCC), U1M2.SLUG1 (VCC)
unnamed: R2M2.1, R3M2.2, U1M2.P5 (EN_A)
unnamed: R5M2.2, U1M2.P4 (IN_A)
unnamed: D1M1.C, D2M1.A, R12M1.1
unnamed: R1M2.1, R4M2.1, U1M2.P9 (EN_B)
unnamed: R6M2.1, U1M2.P10 (IN_B)
unnamed: R8M2.2, R10M2.2, U1M2.P8 (CS)
unnamed: R7M2.1, U1M2.P7 (PWM_IN)
unnamed: D1M2.C, D2M2.A, R12M2.1
unnamed: C2M3.+, C3M3.1, Q1M3.4 (D), U1M3.P3 (VCC), U1M3.P13 (VCC), U1M3.P23 (VCC), U1M3.SLUG1 (VCC)
unnamed: R2M3.1, R3M3.2, U1M3.P5 (EN_A)
unnamed: R5M3.2, U1M3.P4 (IN_A)
unnamed: R1M3.1, R4M3.1, U1M3.P9 (EN_B)
unnamed: R6M3.1, U1M3.P10 (IN_B)
unnamed: R8M3.2, R10M3.2, U1M3.P8 (CS)
unnamed: R7M3.1, U1M3.P7 (PWM_IN)
unnamed: D1M3.C, D2M3.A, R12M3.1
unnamed: C2M4.+, C3M4.1, Q1M4.4 (D), U1M4.P3 (VCC), U1M4.P13 (VCC), U1M4.P23 (VCC), U1M4.SLUG1 (VCC)
unnamed: R2M4.1, R3M4.2, U1M4.P5 (EN_A)
unnamed: R5M4.2, U1M4.P4 (IN_A)
unnamed: R1M4.1, R4M4.1, U1M4.P9 (EN_B)
unnamed: R6M4.1, U1M4.P10 (IN_B)
unnamed: R8M4.2, R10M4.2, U1M4.P8 (CS)
unnamed: R7M4.1, U1M4.P7 (PWM_IN)
unnamed: D1M4.C, D2M4.A, R12M4.1
OUTAM1: D1M1.A, D2M1.C, J1M1.1, U1M1.P1 (OUT_A), U1M1.P25 (OUT_A), U1M1.P30 (OUT_A), U1M1.SLUG2 (OUT_A)
OUTAM2: D1M2.A, D2M2.C, J1M2.1, U1M2.P1 (OUT_A), U1M2.P25 (OUT_A), U1M2.P30 (OUT_A), U1M2.SLUG2 (OUT_A)
OUTAM3: D1M3.A, D2M3.C, J1M3.1, U1M3.P1 (OUT_A), U1M3.P25 (OUT_A), U1M3.P30 (OUT_A), U1M3.SLUG2 (OUT_A)
OUTAM4: D1M4.A, D2M4.C, J1M4.1, U1M4.P1 (OUT_A), U1M4.P25 (OUT_A), U1M4.P30 (OUT_A), U1M4.SLUG2 (OUT_A)
OUTBM1: J1M1.3, R12M1.2, U1M1.P15 (OUT_B), U1M1.P16 (OUT_B), U1M1.P21 (OUT_B), U1M1.SLUG3 (OUT_B)
OUTBM2: J1M2.3, R12M2.2, U1M2.P15 (OUT_B), U1M2.P16 (OUT_B), U1M2.P21 (OUT_B), U1M2.SLUG3 (OUT_B)
OUTBM3: J1M3.3, R12M3.2, U1M3.P15 (OUT_B), U1M3.P16 (OUT_B), U1M3.P21 (OUT_B), U1M3.SLUG3 (OUT_B)
OUTBM4: J1M4.3, R12M4.2, U1M4.P15 (OUT_B), U1M4.P16 (OUT_B), U1M4.P21 (OUT_B), U1M4.SLUG3 (OUT_B)
PWMM1: R7M1.2, R11M1.2; also elsewhere on the board
PWMM2: R7M2.2, R11M2.2; also elsewhere on the board
PWMM3: R7M3.2, R11M3.2; also elsewhere on the board
PWMM4: R7M4.2, R11M4.2; also elsewhere on the board
VCC_1: Q1M1.3 (S), Q1M2.3 (S), Q1M3.3 (S), Q1M4.3 (S), U1M1.P12 (VBAT), U1M2.P12 (VBAT), U1M3.P12 (VBAT), U1M4.P12 (VBAT); also elsewhere on the board

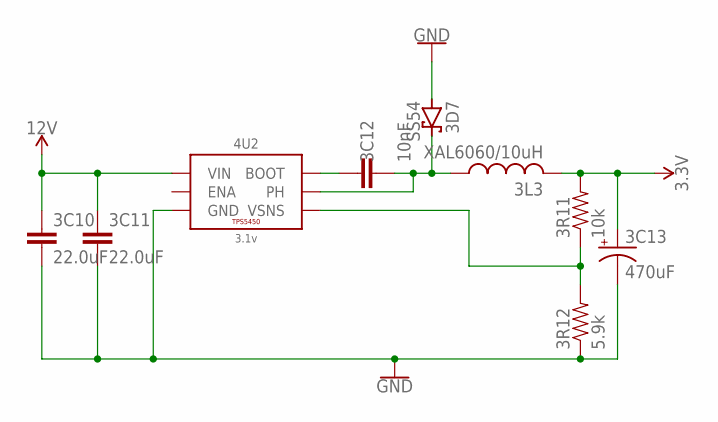
[picture p15: schematic PCB1.sch, sheet 3, Boost & Step Down]

Parts:
3C10, 3C11: 22.0uF; 1210
3C12: 10nF; 0603
3C13: 470uF; D/7343-31R
3D7: SS54; SMB
3L3: XAL6060/10uH; XAL6060
3R11: 10k; 0603
3R12: 5.9k; 0603
4U2: 3.1v; POWERPAD-SOIC-8

Connections:
3.3V: 3C13.+, 3L3.2, 3R11.2; also elsewhere on the board
12V: 3C10.1, 3C11.1, 4U2.7 (VIN); also elsewhere on the board
GND: 3C10.2, 3C11.2, 3C13.-, 3D7.A, 3R12.1, 4U2.6 (GND), 4U2.9 (GND), 4U2.P$1 (GND), 4U2.P$2 (GND), 4U2.P$3 (GND), 4U2.P$4 (GND), 4U2.P$5 (GND), 4U2.P$6 (GND); also elsewhere on the board
unnamed: 3C12.1, 4U2.1 (BOOT)
unnamed: 3C12.2, 3D7.C, 3L3.1, 4U2.8 (PH)
unnamed: 3R11.1, 3R12.2, 4U2.4 (VSNS)

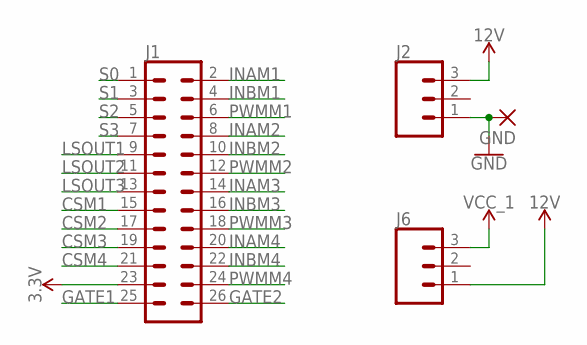
[picture p16: schematic PCB1.sch, sheet 4, Connectors]

Parts:
GND: 3,17/1,1
J1: CONN_13X22X13; 2X13
J2, J6: CONN_03-SCREW-5MM; SCREWTERMINAL-5MM-3

Connections:
3.3V: J1.23; also elsewhere on the board
12V: J2.3, J6.1; also elsewhere on the board
CSM1: J1.15; also elsewhere on the board
CSM2: J1.17; also elsewhere on the board
CSM3: J1.19; also elsewhere on the board
CSM4: J1.21; also elsewhere on the board
GATE1: J1.25; also elsewhere on the board
GATE2: J1.26; also elsewhere on the board
GND: GND.1, J2.1; also elsewhere on the board
INAM1: J1.2; also elsewhere on the board
INAM2: J1.8; also elsewhere on the board
INAM3: J1.14; also elsewhere on the board
INAM4: J1.20; also elsewhere on the board
INBM1: J1.4; also elsewhere on the board
INBM2: J1.10; also elsewhere on the board
INBM3: J1.16; also elsewhere on the board
INBM4: J1.22; also elsewhere on the board
LSOUT1: J1.9; also elsewhere on the board
LSOUT2: J1.11; also elsewhere on the board
LSOUT3: J1.13; also elsewhere on the board
PWMM1: J1.6; also elsewhere on the board
PWMM2: J1.12; also elsewhere on the board
PWMM3: J1.18; also elsewhere on the board
PWMM4: J1.24; also elsewhere on the board
S0: J1.1; also elsewhere on the board
S1: J1.3; also elsewhere on the board
S2: J1.5; also elsewhere on the board
S3: J1.7; also elsewhere on the board
VCC_1: J6.3; also elsewhere on the board

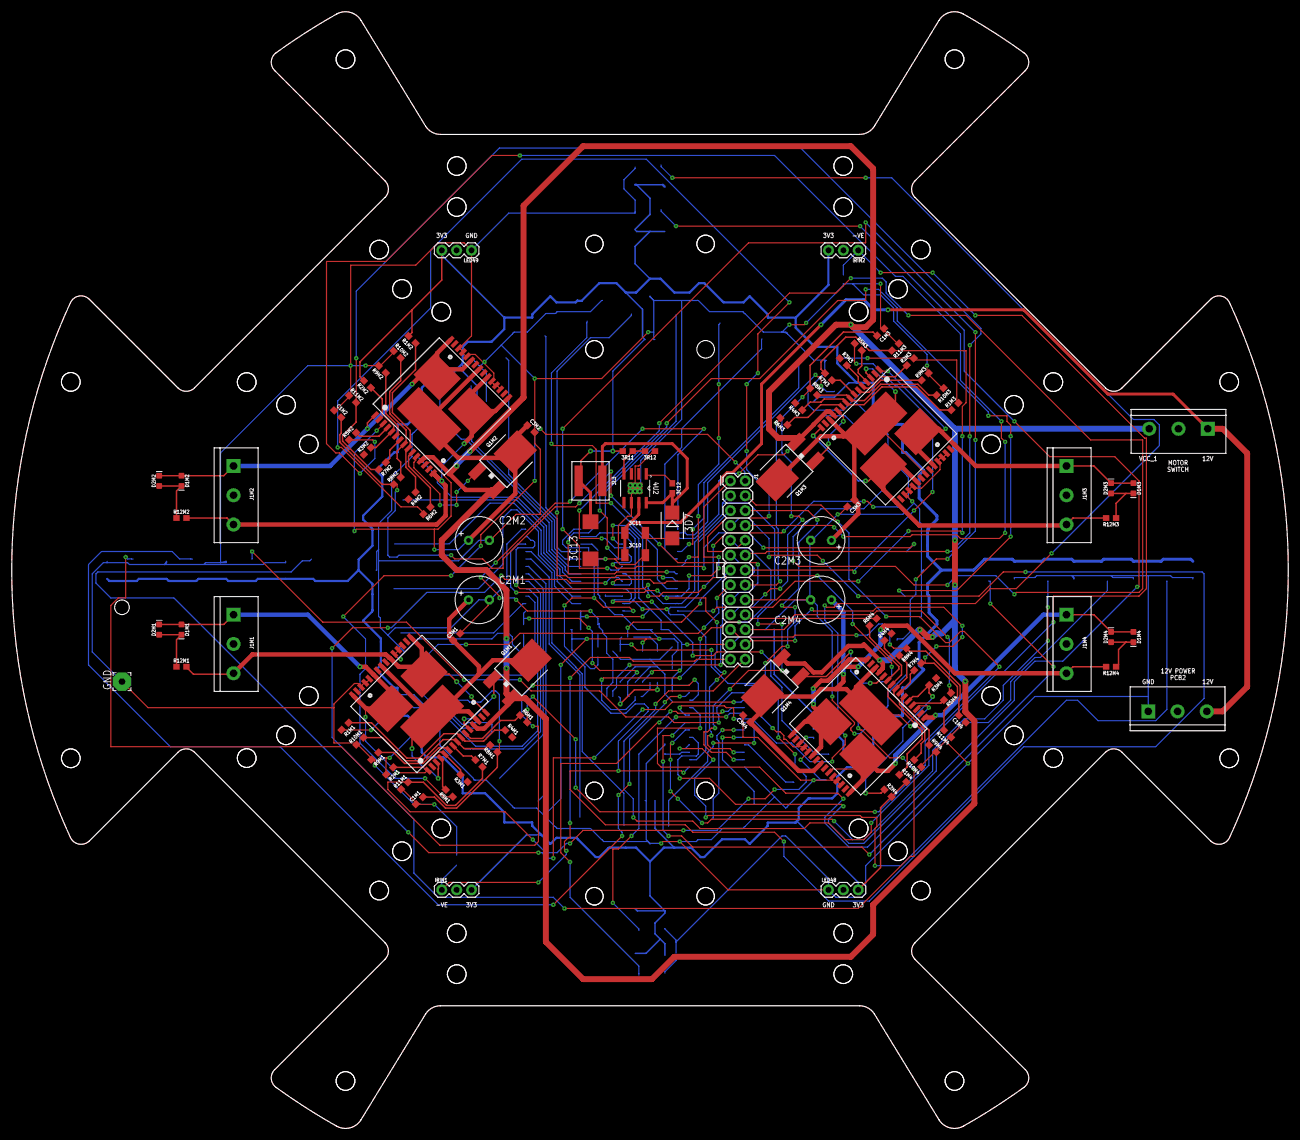
[picture p17: board PCB1.brd from above]

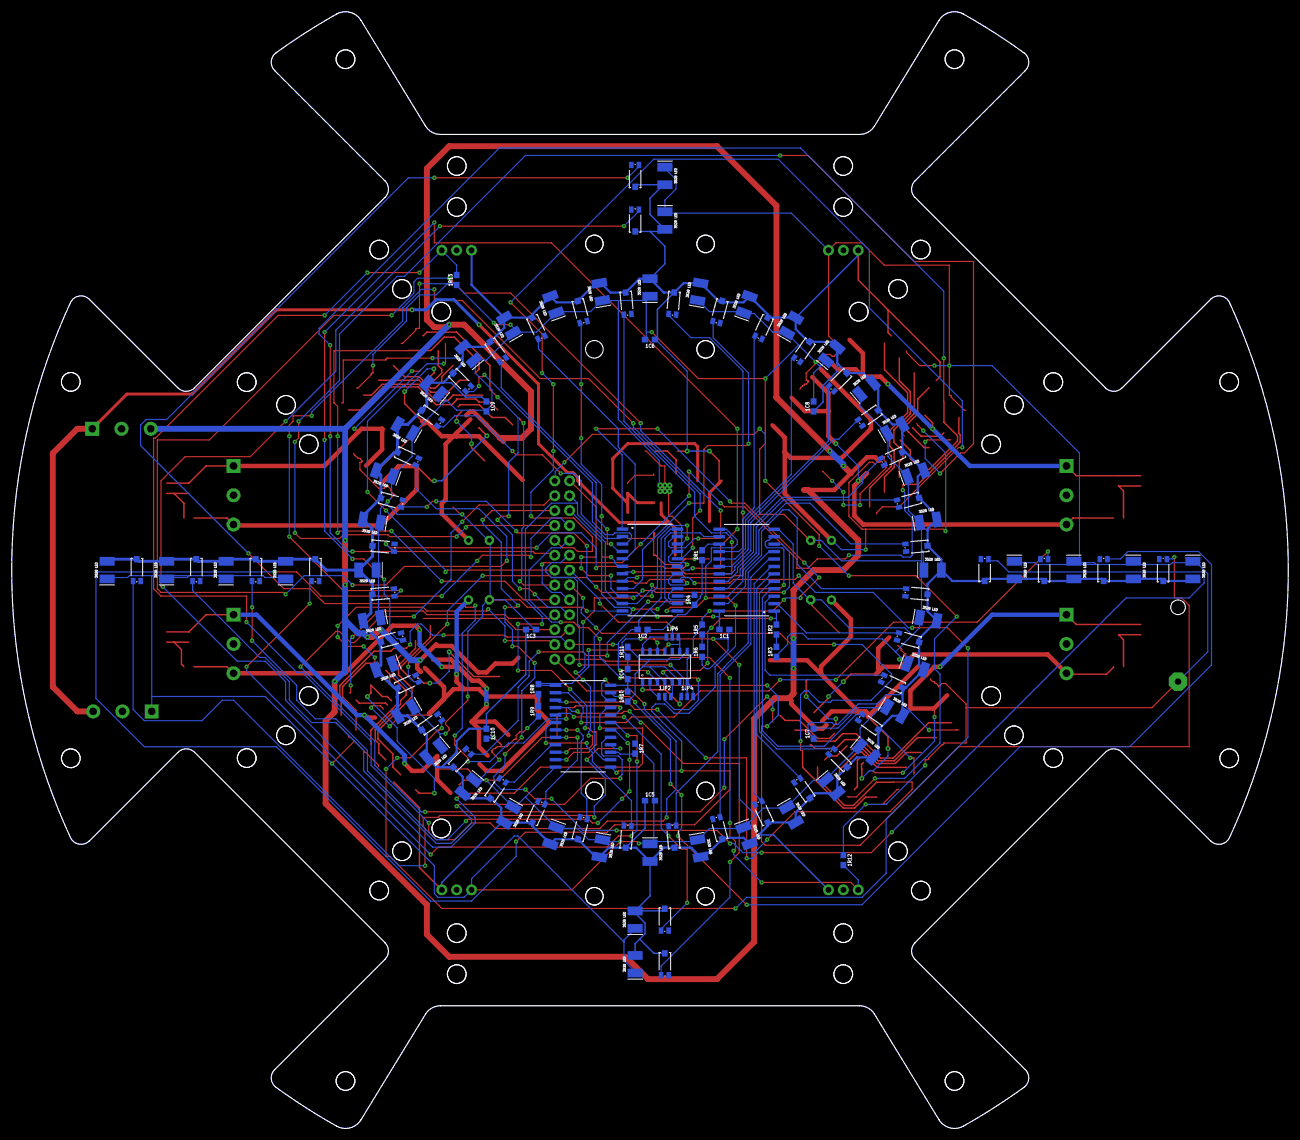
[picture p18: board PCB1.brd from below]

Board: 2 copper layers, 218.0 x 190.7 mm, 223 parts (126 on the bottom side), 141 nets.
