bozotics/soccer2019/PCB/projects/maplemini/maplemini.brd

## EAGLE design PCB/projects/maplemini/maplemini.brd (2018-12-16)

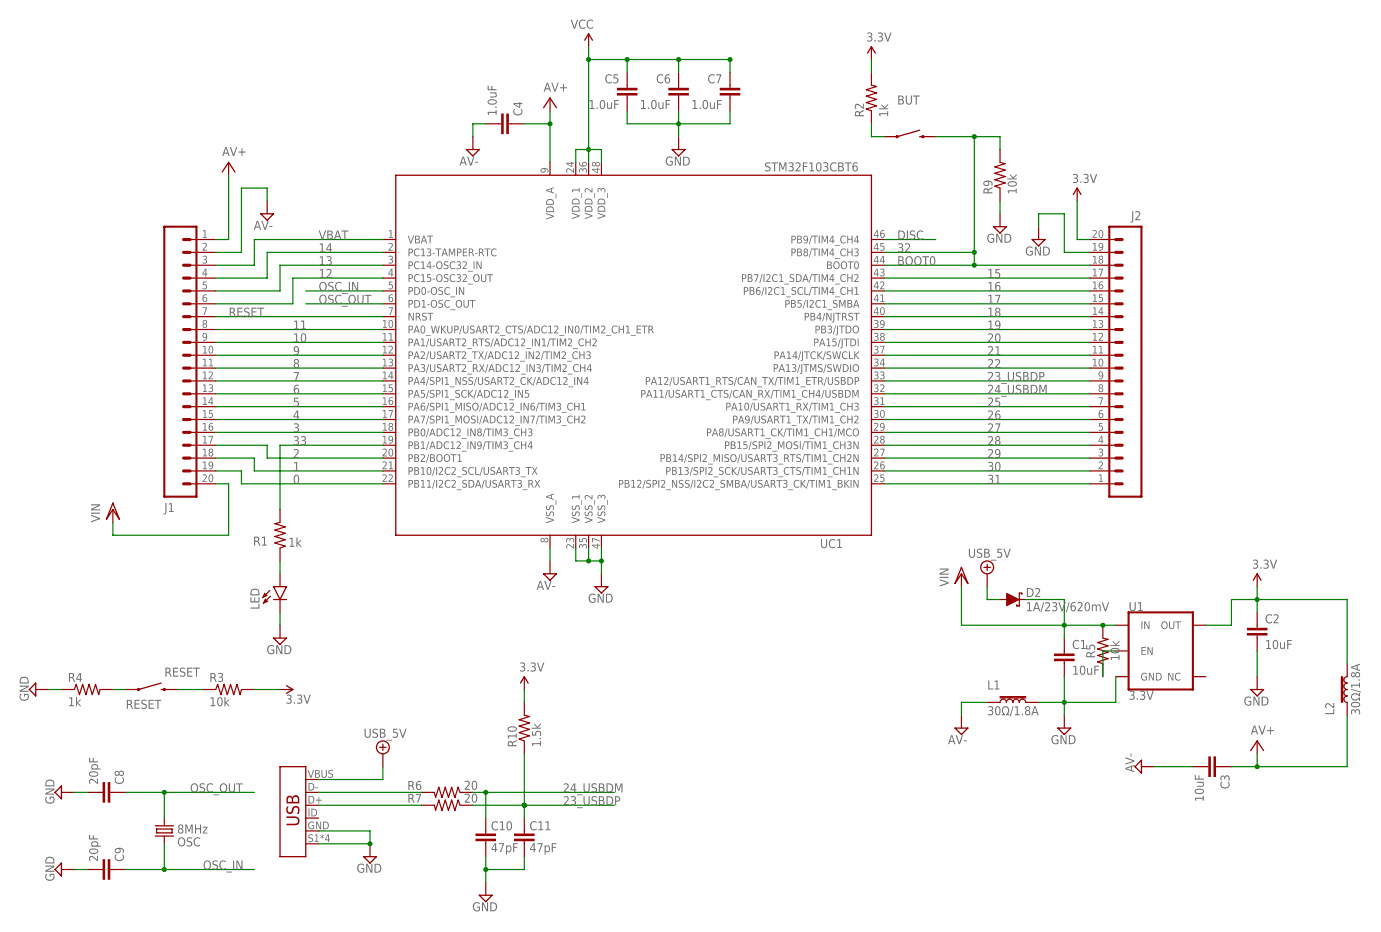
[picture p19: schematic maplemini.sch]

Parts:
BUT: KMR211GLFS; 3*4-MOMENTARY-SWITCH
C1, C2, C3: 10uF; 0603
C4, C5, C6, C7: 1.0uF; 0603
C8, C9: 20pF; 0603
C10, C11: 47pF; 0603
D2: 1A/23V/620mV; SOD-323
J1, J2: CONN_20LOCK; 1X20_LOCK
L1, L2: 30Ω/1.8A; 0603
LED: RED; LED-1206
OSC: 8MHz; CRYSTAL-SMD-5X3.2-2PAD
R1, R2, R4: 1k; 0603
R3, R5, R9: 10k; 0603
R6, R7: 20; 0603
R10: 1.5k; 0603
RESET: KMR211GLFS; 3*4-MOMENTARY-SWITCH
U1: 3.3V; SOT23-5
UC1: STM32F103CBT6; LQFP48
X1: USB-MINIB

Connections:
0: J1.19, UC1.22 (PB11/I2C2_SDA/USART3_RX)
1: J1.18, UC1.21 (PB10/I2C2_SCL/USART3_TX)
2: J1.17, UC1.20 (PB2/BOOT1)
3: J1.16, UC1.18 (PB0/ADC12_IN8/TIM3_CH3)
4: J1.15, UC1.17 (PA7/SPI1_MOSI/ADC12_IN7/TIM3_CH2)
5: J1.14, UC1.16 (PA6/SPI1_MISO/ADC12_IN6/TIM3_CH1)
6: J1.13, UC1.15 (PA5/SPI1_SCK/ADC12_IN5)
7: J1.12, UC1.14 (PA4/SPI1_NSS/USART2_CK/ADC12_IN4)
8: J1.11, UC1.13 (PA3/USART2_RX/ADC12_IN3/TIM2_CH4)
9: J1.10, UC1.12 (PA2/USART2_TX/ADC12_IN2/TIM2_CH3)
10: J1.9, UC1.11 (PA1/USART2_RTS/ADC12_IN1/TIM2_CH2)
11: J1.8, UC1.10 (PA0_WKUP/USART2_CTS/ADC12_IN0/TIM2_CH1_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)
12: J1.6, UC1.4 (PC15-OSC32_OUT)
13: J1.5, UC1.3 (PC14-OSC32_IN)
14: J1.4, UC1.2 (PC13-TAMPER-RTC)
15: J2.17, UC1.43 (PB7/I2C1_SDA/TIM4_CH2)
16: J2.16, UC1.42 (PB6/I2C1_SCL/TIM4_CH1)
17: J2.15, UC1.41 (PB5/I2C1_SMBA)
18: J2.14, UC1.40 (PB4/NJTRST)
19: J2.13, UC1.39 (PB3/JTDO)
20: J2.12, UC1.38 (PA15/JTDI)
21: J2.11, UC1.37 (PA14/JTCK/SWCLK)
22: J2.10, UC1.34 (PA13/JTMS/SWDIO)
23_USBDP: C11.2, J2.9, R7.1, R10.1, UC1.33 (PA12/USART1_RTS/CAN_TX/TIM1_ETR/USBDP)
24_USBDM: C10.2, J2.8, R6.1, UC1.32 (PA11/USART1_CTS/CAN_RX/TIM1_CH4/USBDM)
25: J2.7, UC1.31 (PA10/USART1_RX/TIM1_CH3)
26: J2.6, UC1.30 (PA9/USART1_TX/TIM1_CH2)
27: J2.5, UC1.29 (PA8/USART1_CK/TIM1_CH1/MCO)
28: J2.4, UC1.28 (PB15/SPI2_MOSI/TIM1_CH3N)
29: J2.3, UC1.27 (PB14/SPI2_MISO/USART3_RTS/TIM1_CH2N)
30: J2.2, UC1.26 (PB13/SPI2_SCK/USART3_CTS/TIM1_CH1N)
31: J2.1, UC1.25 (PB12/SPI2_NSS/I2C2_SMBA/USART3_CK/TIM1_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)
32: BUT.P2 (2), J2.18, R9.2, UC1.44 (BOOT0), UC1.45 (PB8/TIM4_CH3)
33: R1.2, UC1.19 (PB1/ADC12_IN9/TIM3_CH4)
+5V/2: D2.A, X1.VBUS
AV+: C3.1, C4.1, J1.1, L2.1, UC1.9 (VDD_A)
AV-: C3.2, C4.2, J1.2, L1.1, UC1.8 (VSS_A)
DGND: C1.2, C2.2, C5.2, C6.2, C7.2, C8.2, C9.2, C10.1, C11.1, J2.19, L1.2, LED.C, R4.1, R9.1, U1.2 (GND), UC1.23 (VSS_1), UC1.35 (VSS_2), UC1.47 (VSS_3), X1.GND, X1.S1 (SHIELD), X1.S2 (SHIELD), X1.S3 (SHIELD), X1.S4 (SHIELD)
DISC: UC1.46 (PB9/TIM4_CH4)
unnamed: BUT.P1 (1), R2.1
unnamed: LED.A, R1.1
unnamed: R5.1, U1.3 (EN)
unnamed: R4.2, RESET.P1 (1)
unnamed: R6.2, X1.D-
unnamed: R7.2, X1.D+
OSC_IN: C9.1, OSC.P$2 (2), UC1.5 (PD0-OSC_IN)
OSC_OUT: C8.1, OSC.P$1 (1), UC1.6 (PD1-OSC_OUT)
RESET: J1.7, R3.1, RESET.P2 (2), UC1.7 (NRST)
VBAT: J1.3, UC1.1 (VBAT)
VCC: C2.1, C5.1, C6.1, C7.1, J2.20, L2.2, R2.2, R3.2, R10.2, U1.5 (OUT), UC1.24 (VDD_1), UC1.36 (VDD_2), UC1.48 (VDD_3)
VIN: C1.1, D2.C, J1.20, R5.2, U1.1 (IN)

Notes on the sheet:
BOOT0

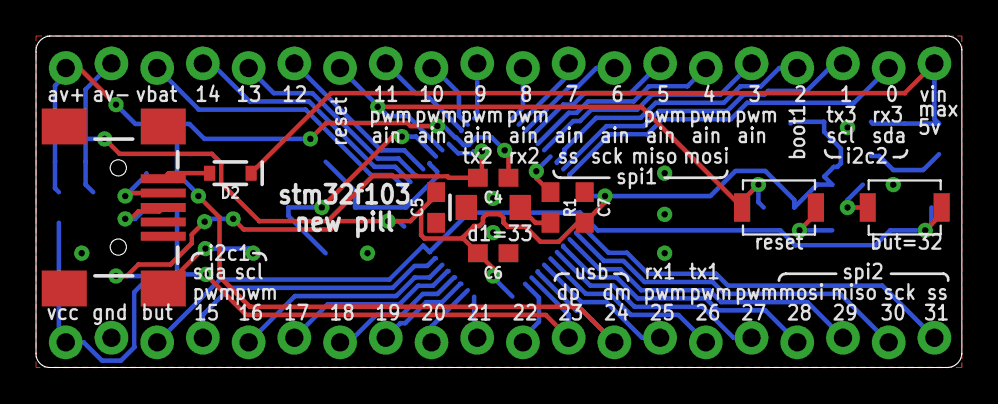
[picture p20: board maplemini.brd from above]

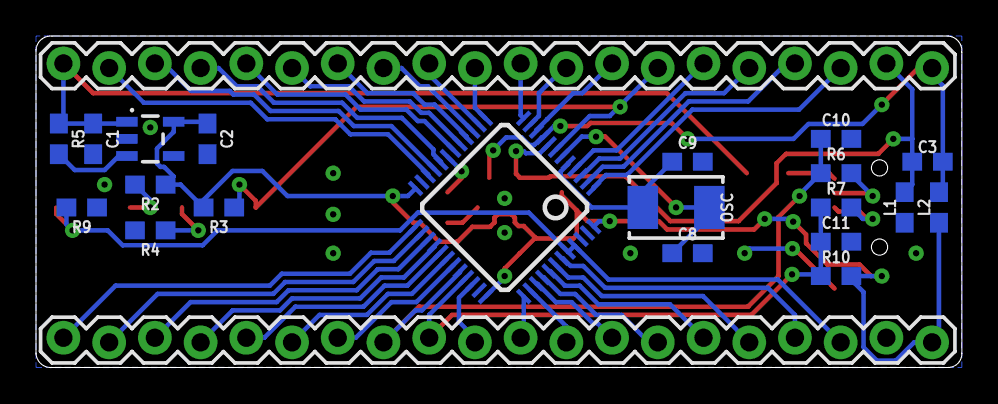
[picture p21: board maplemini.brd from below]

Board: 2 copper layers, 51.4 x 18.4 mm, 32 parts (22 on the bottom side), 50 nets.
