bozotics/soccer2019/PCB/projects/TestV2/TestV2.brd

## EAGLE design PCB/projects/TestV2/TestV2.brd (2018-12-16)

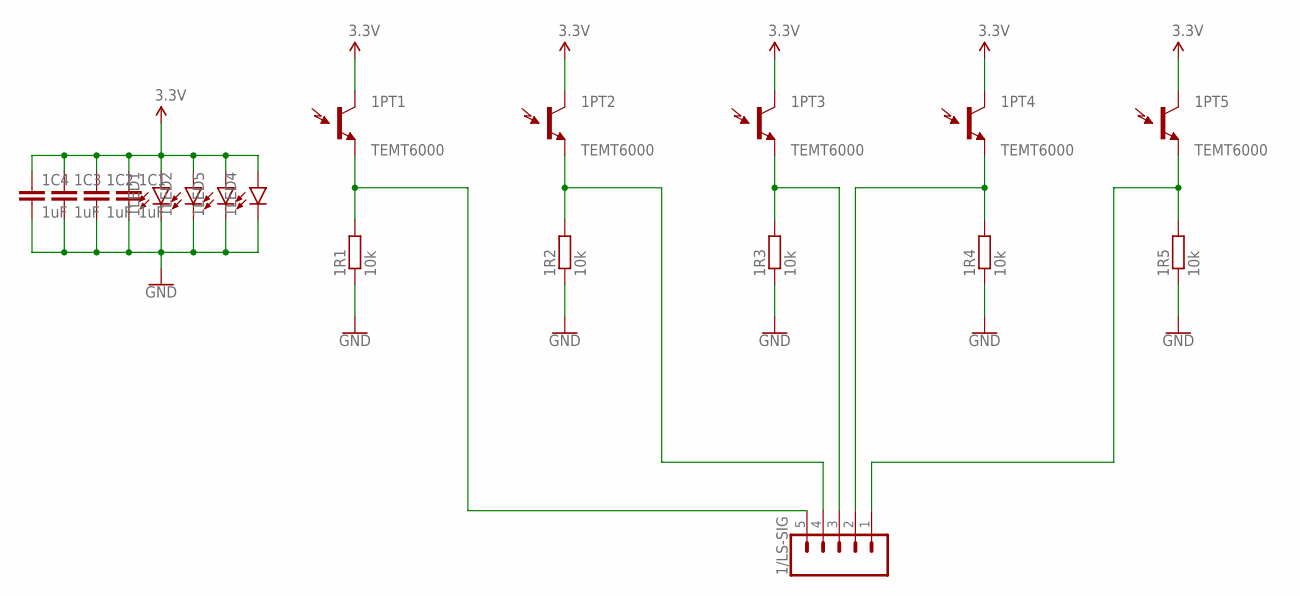
[picture p22: schematic TestV2.sch, sheet 1, Light Sensor Circuit]

Parts:
1/LS-SIG: CONN_05LOCK; 1X05_LOCK
1C1, 1C2, 1C3, 1C4: 1uF; C0603
1LED1, 1LED2, 1LED4, 1LED5: 3528LED; 3528
1PT1, 1PT2, 1PT3, 1PT4, 1PT5: TEMT6000
1R1, 1R2, 1R3, 1R4, 1R5: 10k; R0603

Connections:
3.3V: 1C1.1, 1C2.1, 1C3.1, 1C4.1, 1LED1.A, 1LED2.A, 1LED4.A, 1LED5.A, 1PT1.COLLECTOR (C1), 1PT2.COLLECTOR (C1), 1PT3.COLLECTOR (C1), 1PT4.COLLECTOR (C1), 1PT5.COLLECTOR (C1); also elsewhere on the board
GND: 1C1.2, 1C2.2, 1C3.2, 1C4.2, 1LED1.C, 1LED2.C, 1LED4.C, 1LED5.C, 1R1.1, 1R2.1, 1R3.1, 1R4.1, 1R5.1; also elsewhere on the board
unnamed: 1/LS-SIG.4, 1PT2.EMITTER (E1), 1R2.2
unnamed: 1/LS-SIG.3, 1PT3.EMITTER (E1), 1R3.2
unnamed: 1/LS-SIG.2, 1PT4.EMITTER (E1), 1R4.2
unnamed: 1/LS-SIG.1, 1PT5.EMITTER (E1), 1R5.2
unnamed: 1/LS-SIG.5, 1PT1.EMITTER (E1), 1R1.2

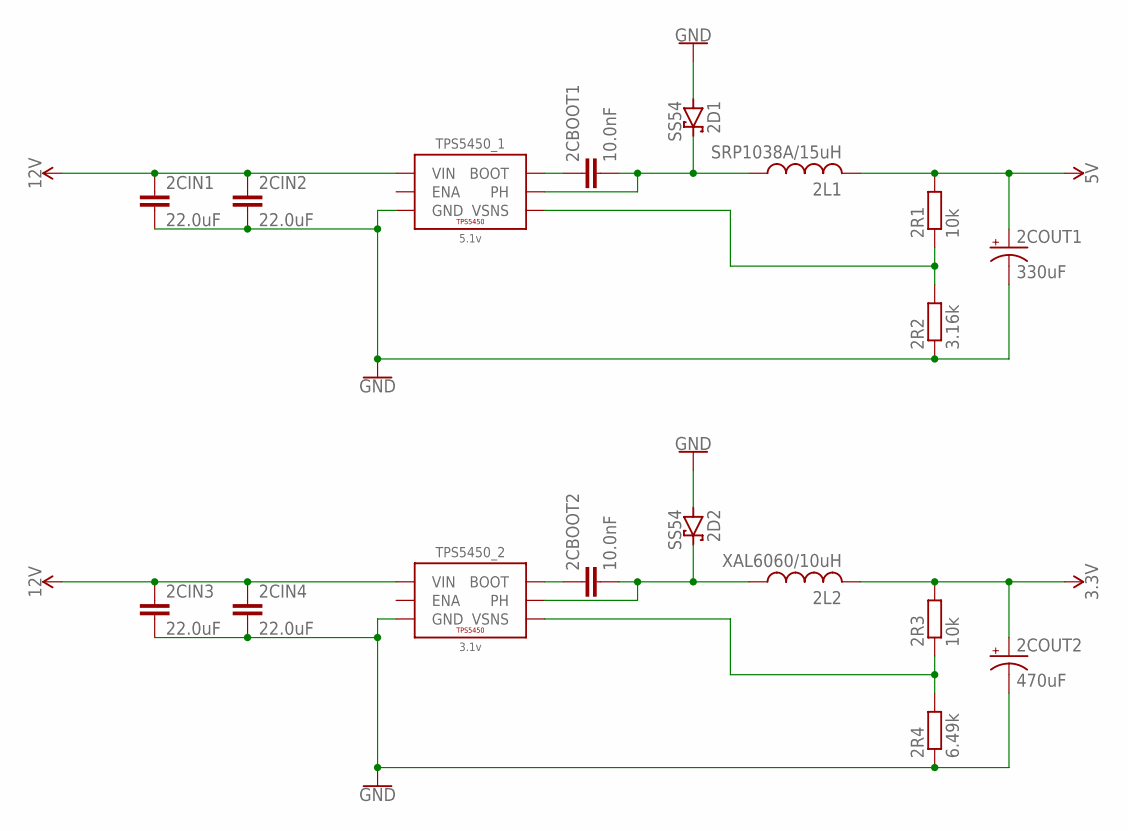
[picture p23: schematic TestV2.sch, sheet 2, TPS5450 Buck Circuit]

Parts:
2CBOOT1, 2CBOOT2: 10.0nF; C0603
2CIN1, 2CIN2, 2CIN3, 2CIN4: 22.0uF; C1210
2COUT1: 330uF; D/7343-31R
2COUT2: 470uF; D/7343-31R
2D1, 2D2: SS54; SMB
2L1: SRP1038A/15uH; SRP1038A
2L2: XAL6060/10uH; XAL6060
2R1, 2R3: 10k; R0603
2R2: 3.16k; R0603
2R4: 6.49k; R0603
TPS5450_1: 5.1v; POWERPAD-SOIC-8
TPS5450_2: 3.1v; POWERPAD-SOIC-8

Connections:
3.3V: 2COUT2.+, 2L2.2, 2R3.2; also elsewhere on the board
5V: 2COUT1.+, 2L1.2, 2R1.2; also elsewhere on the board
12V: 2CIN1.1, 2CIN2.1, 2CIN3.1, 2CIN4.1, TPS5450_1.7 (VIN), TPS5450_2.7 (VIN); also elsewhere on the board
GND: 2CIN1.2, 2CIN2.2, 2CIN3.2, 2CIN4.2, 2COUT1.-, 2COUT2.-, 2D1.A, 2D2.A, 2R2.1, 2R4.1, TPS5450_1.6 (GND), TPS5450_1.9 (GND), TPS5450_1.P$1 (GND), TPS5450_1.P$2 (GND), TPS5450_1.P$3 (GND), TPS5450_1.P$4 (GND), TPS5450_1.P$5 (GND), TPS5450_1.P$6 (GND), TPS5450_2.6 (GND), TPS5450_2.9 (GND), TPS5450_2.P$1 (GND), TPS5450_2.P$2 (GND), TPS5450_2.P$3 (GND), TPS5450_2.P$4 (GND), TPS5450_2.P$5 (GND), TPS5450_2.P$6 (GND); also elsewhere on the board
unnamed: 2CBOOT1.2, 2D1.C, 2L1.1, TPS5450_1.8 (PH)
unnamed: 2CBOOT2.1, TPS5450_2.1 (BOOT)
unnamed: 2CBOOT1.1, TPS5450_1.1 (BOOT)
unnamed: 2R1.1, 2R2.2, TPS5450_1.4 (VSNS)
unnamed: 2CBOOT2.2, 2D2.C, 2L2.1, TPS5450_2.8 (PH)
unnamed: 2R3.1, 2R4.2, TPS5450_2.4 (VSNS)

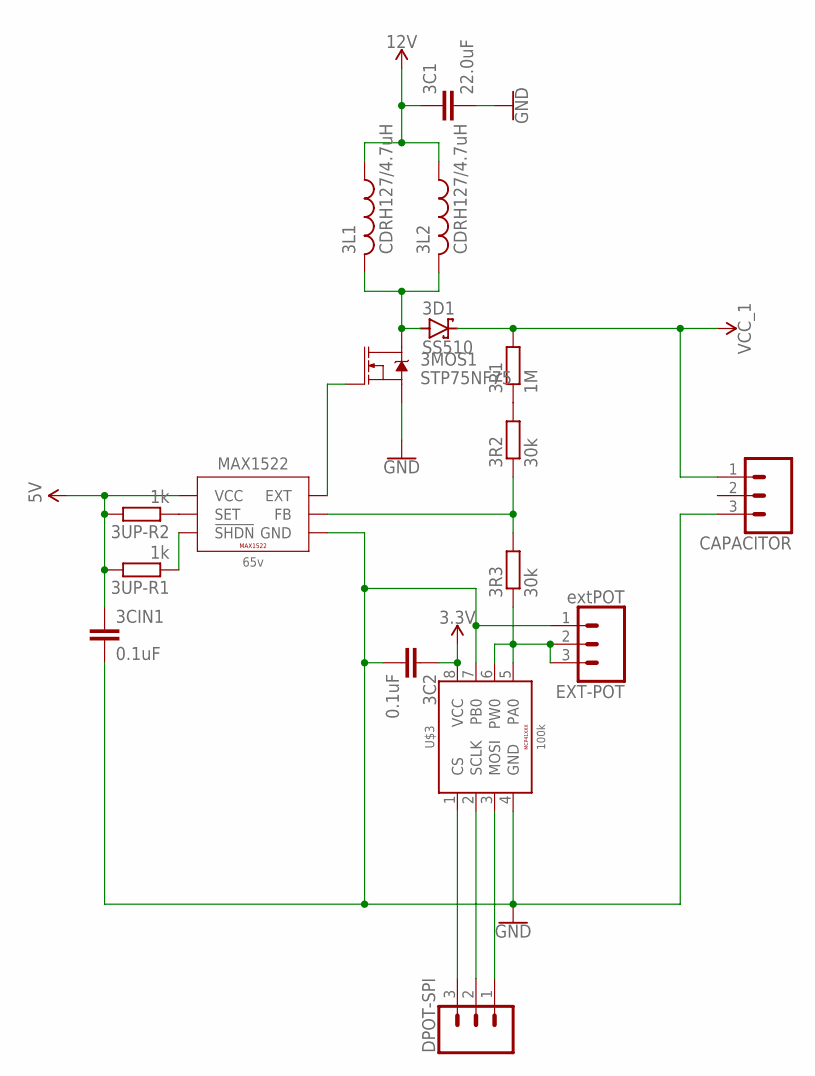
[picture p24: schematic TestV2.sch, sheet 3, MAX1522 Boost Converter Circuit]

Parts:
3C1: 22.0uF; C1210
3C2, 3CIN1: 0.1uF; C0603
3D1: SS510; SMB
3L1, 3L2: CDRH127/4.7uH; 127
3MOS1: STP75NF75; TO220V
3R1: 1M; R0603
3R2, 3R3: 30k; R0603
3UP-R1, 3UP-R2: 1k; R0603
CAPACITOR: CONN_03-SCREW-5MM; SCREWTERMINAL-5MM-3
DPOT-SPI: CONN_03LOCK; 1X03_LOCK
EXT-POT: extPOT; 1X03
MAX1522: 65v; SOT23-6
U$3: 100k; SOIC-8

Connections:
3.3V: 3C2.1, U$3.8 (VCC); also elsewhere on the board
5V: 3CIN1.1, 3UP-R1.2, 3UP-R2.2, MAX1522.6 (VCC); also elsewhere on the board
12V: 3C1.1, 3L1.1, 3L2.1; also elsewhere on the board
GND: 3C1.2, 3C2.2, 3CIN1.2, 3MOS1.3 (S), CAPACITOR.3, EXT-POT.1, MAX1522.1 (GND), U$3.4 (GND), U$3.7 (PB0); also elsewhere on the board
unnamed: 3R1.1, 3R2.2
unnamed: 3R2.1, 3R3.2, MAX1522.2 (FB)
unnamed: 3MOS1.1 (G), MAX1522.5 (EXT)
unnamed: 3R3.1, EXT-POT.2, EXT-POT.3, U$3.5 (PA0), U$3.6 (PW0)
unnamed: 3D1.A, 3L1.2, 3L2.2, 3MOS1.2 (D)
unnamed: 3UP-R1.1, MAX1522.4 (!SHDN)
unnamed: 3UP-R2.1, MAX1522.3 (SET)
unnamed: DPOT-SPI.3, U$3.1 (CS)
unnamed: DPOT-SPI.2, U$3.2 (SCLK)
unnamed: DPOT-SPI.1, U$3.3 (MOSI)
VCC_1: 3D1.C, 3R1.2, CAPACITOR.1; also elsewhere on the board

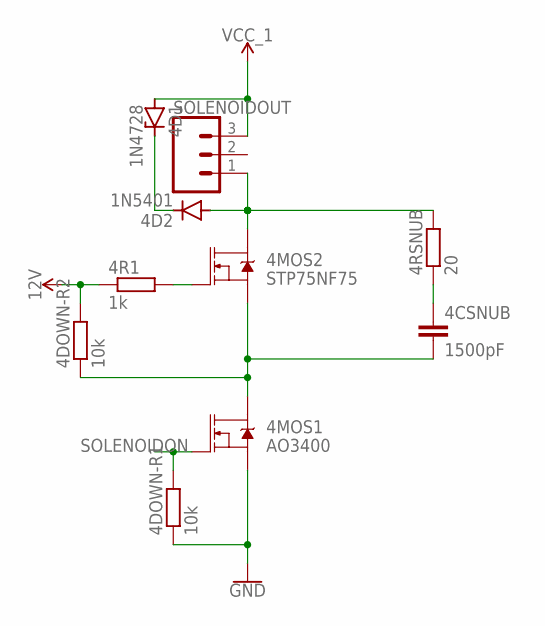
[picture p25: schematic TestV2.sch, sheet 4, Solenoid MOSFET Switch Circuit]

Parts:
4CSNUB: 1500pF; C0603
4D1: 1N4728; DO41Z10
4D2: 1N5401; DO201-15
4DOWN-R1, 4DOWN-R2: 10k; R0603
4MOS1: AO3400; SOT23-3
4MOS2: STP75NF75; TO220V
4R1: 1k; R0603
4RSNUB: 20; R0603
SOLENOIDOUT: CONN_03-SCREW-5MM; SCREWTERMINAL-5MM-3

Connections:
12V: 4DOWN-R2.2, 4R1.1; also elsewhere on the board
GND: 4DOWN-R1.1, 4MOS1.2 (S); also elsewhere on the board
unnamed: 4CSNUB.2, 4DOWN-R2.1, 4MOS1.3 (D), 4MOS2.3 (S)
unnamed: 4MOS2.1 (G), 4R1.2
unnamed: 4D1.C, 4D2.C
unnamed: 4CSNUB.1, 4RSNUB.1
SOLENOID-: 4D2.A, 4MOS2.2 (D), 4RSNUB.2, SOLENOIDOUT.1
SOLENOIDON: 4DOWN-R1.2, 4MOS1.1 (G); also elsewhere on the board
VCC_1: 4D1.A, SOLENOIDOUT.3; also elsewhere on the board

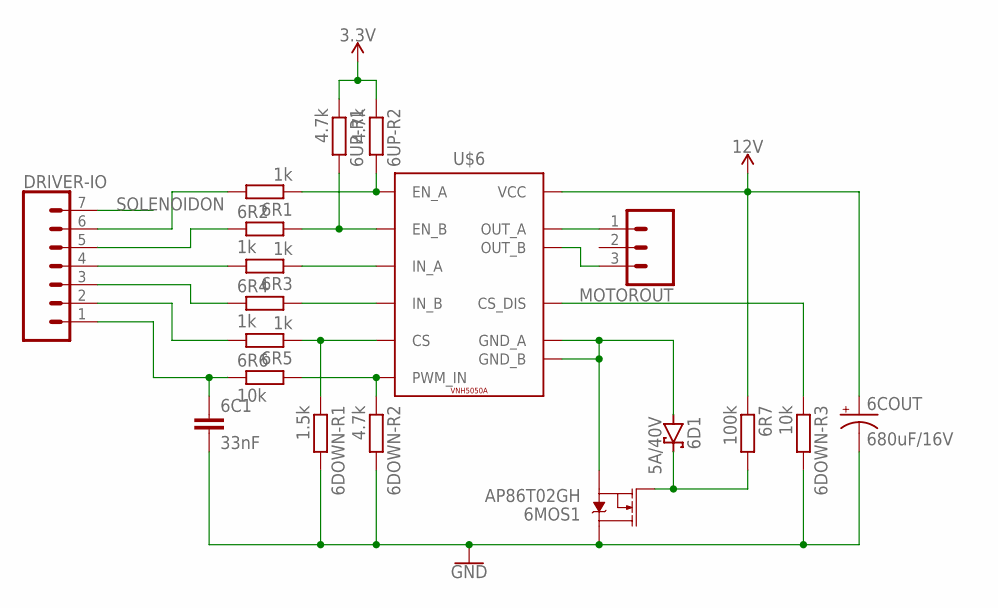
[picture p26: schematic TestV2.sch, sheet 5, VNH5050 Motor Driver Circuit]

Parts:
6C1: 33nF; C0603
6COUT: 680uF/16V; E3,5-8
6D1: 5A/40V; SMB
6DOWN-R1: 1.5k; R0603
6DOWN-R2, 6UP-R1, 6UP-R2: 4.7k; R0603
6DOWN-R3, 6R6: 10k; R0603
6MOS1: AP86T02GH; DPAK
6R1, 6R2, 6R3, 6R4, 6R5: 1k; R0603
6R7: 100k; R0603
DRIVER-IO: CONN_07LOCK; 1X07_LOCK
MOTOROUT: CONN_03-SCREW-5MM; SCREWTERMINAL-5MM-3
U$6: VNH5050A; POWERSSO-36

Connections:
3.3V: 6UP-R1.1, 6UP-R2.1; also elsewhere on the board
12V: 6COUT.+, 6R7.1, U$6.1 (VCC), U$6.P13 (VCC), U$6.P24 (VCC), U$6.P$13 (VCC), U$6.P$14 (VCC), U$6.P$15 (VCC), U$6.P$16 (VCC), U$6.P$17 (VCC), U$6.P$18 (VCC), U$6.P$19 (VCC), U$6.P$20 (VCC), U$6.P$21 (VCC), U$6.P$22 (VCC), U$6.P$23 (VCC), U$6.P$24 (VCC); also elsewhere on the board
CS: 6R5.2, DRIVER-IO.2
EN_A: 6R1.2, DRIVER-IO.6
EN_B: 6R2.1, DRIVER-IO.5
GND: 6C1.2, 6COUT.-, 6DOWN-R1.2, 6DOWN-R2.2, 6DOWN-R3.2, 6MOS1.4 (D); also elsewhere on the board
IN_A: 6R3.2, DRIVER-IO.4
IN_B: 6R4.1, DRIVER-IO.3
unnamed: 6R1.1, 6UP-R2.2, U$6.P16 (EN_A)
unnamed: 6R3.1, U$6.P15 (IN_A)
unnamed: 6R2.2, 6UP-R1.2, U$6.P21 (EN_B)
unnamed: 6R4.2, U$6.P22 (IN_B)
unnamed: 6DOWN-R2.1, 6R6.2, U$6.P17 (PWM_IN)
unnamed: 6DOWN-R1.1, 6R5.1, U$6.P19 (CS)
unnamed: 6D1.A, 6MOS1.3 (S), U$6.P1 (GND_A), U$6.P3 (GND_A), U$6.P4 (GND_A), U$6.P5 (GND_A), U$6.P6 (GND_A), U$6.P7 (GND_A), U$6.P30 (GND_B), U$6.P31 (GND_B), U$6.P32 (GND_B), U$6.P33 (GND_B), U$6.P34 (GND_B), U$6.P36 (GND_B)
unnamed: 6D1.C, 6MOS1.1 (G), 6R7.2
unnamed: 6DOWN-R3.1, U$6.P20 (CS_DIS)
unnamed: MOTOROUT.1, U$6.2 (OUT_A), U$6.P2 (OUT_A), U$6.P8 (OUT_A), U$6.P9 (OUT_A), U$6.P10 (OUT_A), U$6.P11 (OUT_A), U$6.P12 (OUT_A), U$6.P14 (OUT_A), U$6.P$7 (OUT_A), U$6.P$8 (OUT_A), U$6.P$9 (OUT_A), U$6.P$10 (OUT_A), U$6.P$11 (OUT_A), U$6.P$12 (OUT_A)
unnamed: MOTOROUT.3, U$6.3 (OUT_B), U$6.P23 (OUT_B), U$6.P25 (OUT_B), U$6.P26 (OUT_B), U$6.P27 (OUT_B), U$6.P28 (OUT_B), U$6.P29 (OUT_B), U$6.P35 (OUT_B), U$6.P$1 (OUT_B), U$6.P$2 (OUT_B), U$6.P$3 (OUT_B), U$6.P$4 (OUT_B), U$6.P$5 (OUT_B), U$6.P$6 (OUT_B)
PWM: 6C1.1, 6R6.1, DRIVER-IO.1
SOLENOIDON: DRIVER-IO.7; also elsewhere on the board

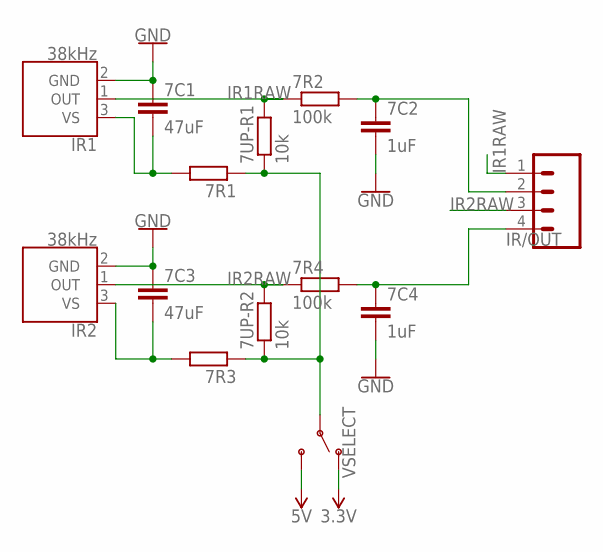
[picture p27: schematic TestV2.sch, sheet 6, IR]

Parts:
7C1, 7C3: 47uF; C0603
7C2, 7C4: 1uF; C0603
7R1, 7R3: R-EU_R0603; R0603
7R2, 7R4: 100k; R0603
7UP-R1, 7UP-R2: 10k; R0603
IR1, IR2: 38kHz; TSOP382
IR/OUT: CONN_04LOCK; 1X04_LOCK
VSELECT: SWITCH-SPDT-PTH-11.6X4.0MM-LOCK; SWITCH_SPDT_PTH_11.6X4.0MM_LOCK

Connections:
3.3V: VSELECT.1 (O); also elsewhere on the board
5V: VSELECT.3 (S); also elsewhere on the board
GND: 7C1.1, 7C2.2, 7C3.1, 7C4.2, IR1.2 (GND), IR2.2 (GND); also elsewhere on the board
IR1RAW: 7R2.1, 7UP-R1.2, IR1.1 (OUT), IR/OUT.1
IR2RAW: 7R4.1, 7UP-R2.2, IR2.1 (OUT), IR/OUT.3
unnamed: 7C1.2, 7R1.2, IR1.3 (VS)
unnamed: 7R1.1, 7R3.1, 7UP-R1.1, 7UP-R2.1, VSELECT.2
unnamed: 7C2.1, 7R2.2, IR/OUT.2
unnamed: 7C3.2, 7R3.2, IR2.3 (VS)
unnamed: 7C4.1, 7R4.2, IR/OUT.4

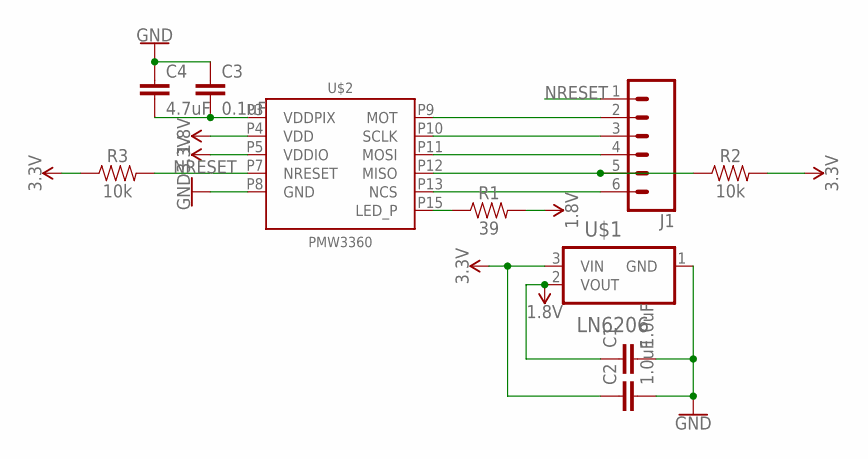
[picture p28: schematic TestV2.sch, sheet 7, PMW3360 Mouse Sensor]

Parts:
C1, C2: 1.0uF; 0603
C3: 0.1uF; 0603
C4: 4.7uF; 0603
J1: CONN_06LOCK; 1X06_LOCK
R1: 39; 0603
R2, R3: 10k; 0603
U$1: LN6206; SOT95P237X112-3N
U$2: PMW3360

Connections:
1.8V: C1.1, R1.2, U$1.2 (VOUT), U$2.P4 (VDD)
3.3V: C2.1, R2.2, R3.1, U$1.3 (VIN), U$2.P5 (VDDIO); also elsewhere on the board
GND: C1.2, C2.2, C3.1, C4.1, U$1.1 (GND), U$2.P8 (GND); also elsewhere on the board
unnamed: R1.1, U$2.P15 (LED_P)
unnamed: J1.6, U$2.P13 (NCS)
unnamed: J1.5, R2.1, U$2.P12 (MISO)
unnamed: J1.4, U$2.P11 (MOSI)
unnamed: J1.3, U$2.P10 (SCLK)
unnamed: J1.2, U$2.P9 (MOT)
unnamed: C3.2, C4.2, U$2.P3 (VDDPIX)
NRESET: J1.1, R3.2, U$2.P7 (NRESET)

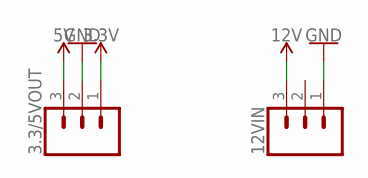
[picture p29: schematic TestV2.sch, sheet 8, Power Input / Outputs]

Parts:
3.3/5VOUT, 12VIN: CONN_03-SCREW-5MM; SCREWTERMINAL-5MM-3

Connections:
3.3V: 3.3/5VOUT.1; also elsewhere on the board
5V: 3.3/5VOUT.3; also elsewhere on the board
12V: 12VIN.3; also elsewhere on the board
GND: 3.3/5VOUT.2, 12VIN.1; also elsewhere on the board

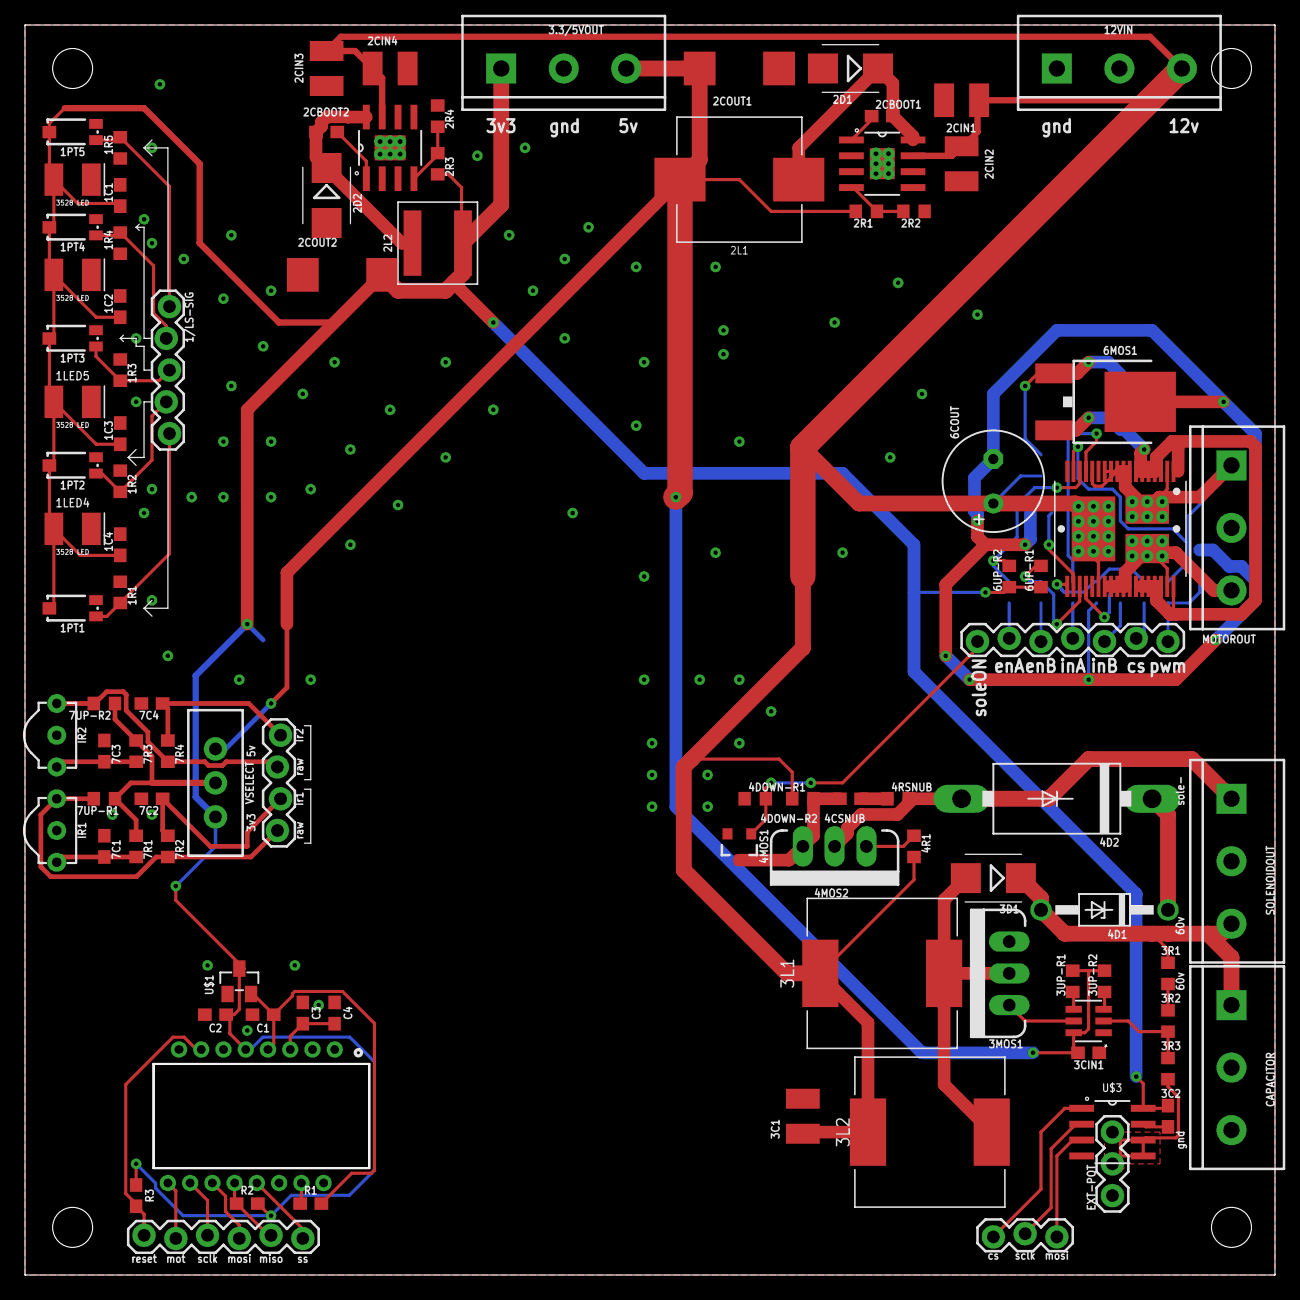
[picture p30: board TestV2.brd from above]

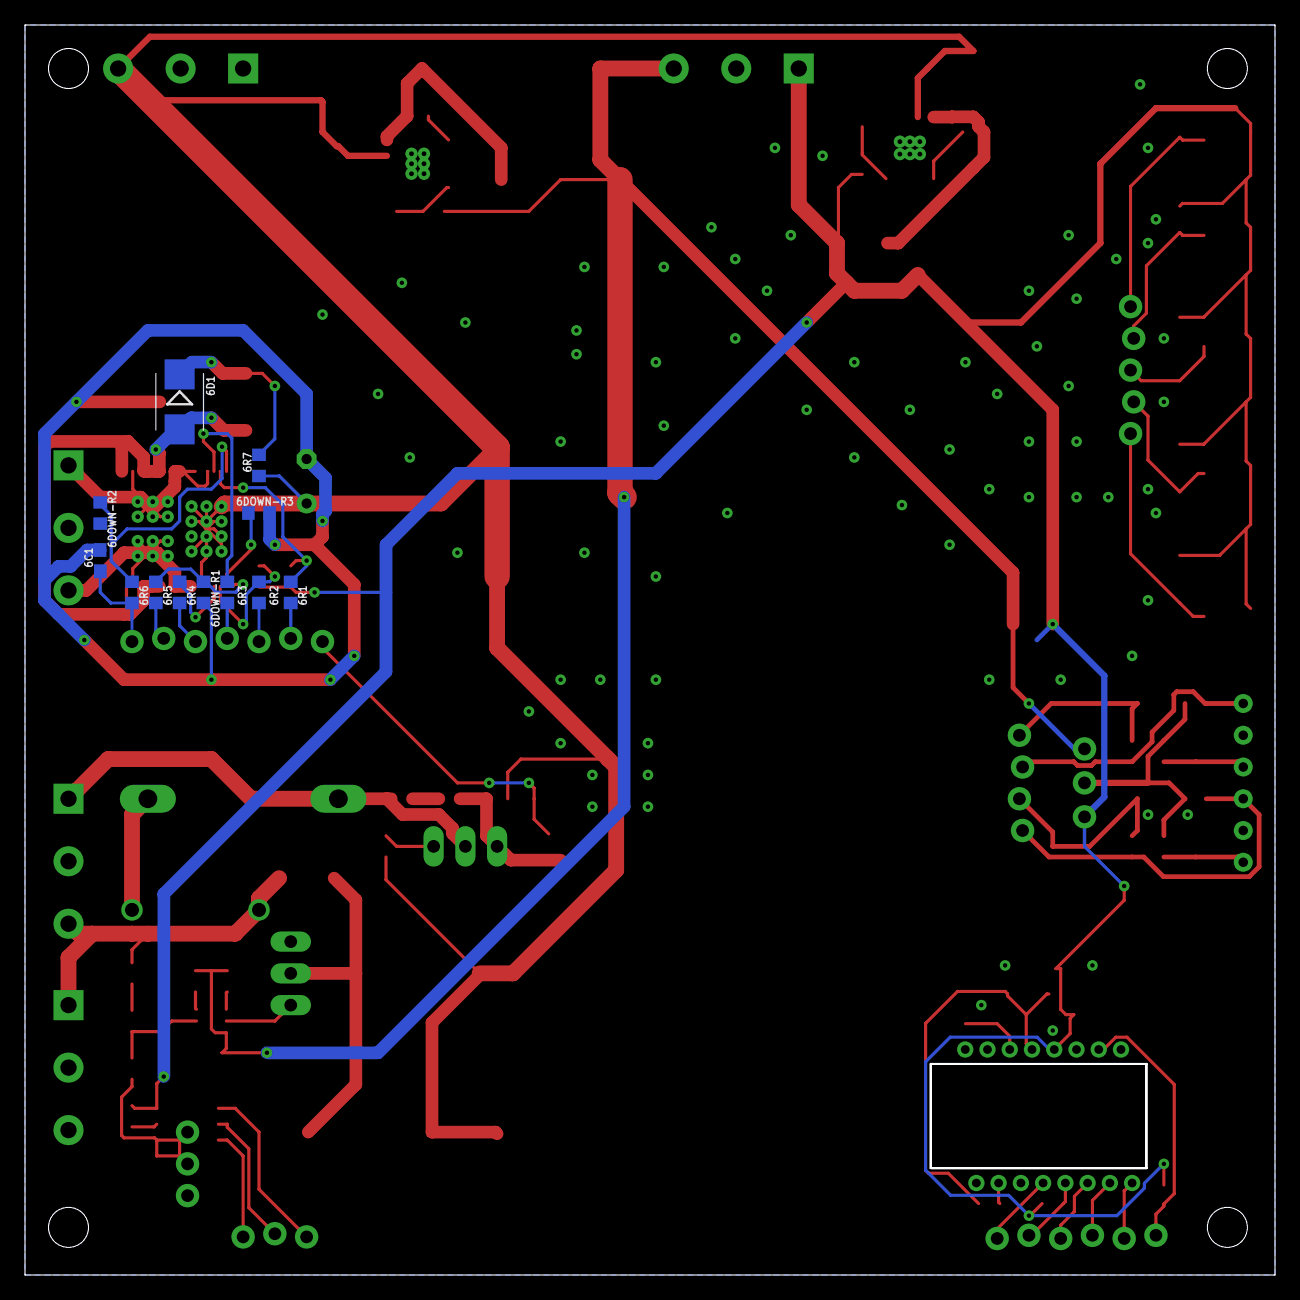
[picture p31: board TestV2.brd from below]

Board: 2 copper layers, 100.0 x 100.0 mm, 109 parts (12 on the bottom side), 65 nets.
