bozotics/soccer2019/(commit log)

2018-10-28 Add PCB Library for MAX1522
2018-11-17 TPS5450 schematic sheet done and others
    [1stLayer2018v1.sch]
2018-11-18 0.1% progress
    [1stLayer2018v1.sch]
2018-11-30 left new pill and adxl, cleaned up some symbols and wrong net names, have to make breakout pins for data pins
    [1stLayer2018v1.sch]
2018-12-03 Naming Scheme Off but 1stLayer2018v1: dead (analogMUX circuit is wrong by the way) Test V1: Schematic which will be used to implement final board Test V2: Deleted MUX and ADXL which will confirm work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
    [TestV1.sch, TestV2.brd, TestV2.sch]
2018-12-05 5/12 PCB Damn proper title names now Made naming a little more consistent not standard but at least I know what's happening [sch sheet number][component prefix][number] did a little board design most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
2018-12-08 8/12 PCB well well well so drunk the original commit name was 9/12 renamed all parts in schematic, then everything went downhill welp was in 1mm grid instead of 1.27mm forgot to check drc before rout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
    [TestV2.brd, TestV2.sch]
2018-12-11 11/12 PCB Updated own DRU file Updated even more stuff in schematic but quite minor, mostly flipping the 5mm screw terminal connections redid the pcb kinda redid the layout and managed to frkin manua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
    [TestV2.brd, TestV2.sch]
2018-12-16 16/12 PCB shit too much happened shld have committed more often but wtv deleted stm32 sheet added IR and mouse sensor Finally routed everything, gerber files are included hopefully done for now
    [TestV2.brd, TestV2.sch]
2018-12-16 16/12 PCB maple mini clone Credits to maple mini for their original design, pretty much took it removed some usb circuitry to make it 2 layered and changed some components only
    [maplemini.brd, maplemini.sch]
2018-12-16 16/12 PCB CAM file update
2018-12-16 Update PCB Library too much happened this the latest update
2019-02-04 5/2 PCB v0.0
    [PCB1_v1.brd, PCB1_v1.sch]
2019-02-24 24/2 PCB v0.2 Finished new VNH5019 Motor Driver circuit, step up/down + solenoid, left with light sensors (+MUX+Comparators) and other sensors and connections. lesgo
    [PCB1_v1.brd, PCB1_v1.sch]
2019-03-14 14/3 PCB v0.5 Finished all the schematics and started placing parts on PCB2.
    [PCB1.sch, PCB2.brd, PCB2.sch]
2019-03-14 15/3 Updated the schematics, labelled of PCB2
    [PCB1.brd, PCB1.sch, PCB2.brd, PCB2.sch]
2019-03-17 17/3 Updated derp in Boost Circuit voltage selection, updated boards even further
    [PCB1.brd, PCB1.sch, PCB2.brd]
2019-03-17 18/3 Moved boost circuit and solenoid circuits to PCB2 else no space
    [PCB1.brd, PCB1.sch, PCB2.brd, PCB2.sch]
2019-03-18 18/3 PCB mostly updated PCB1 layout
    [PCB1.brd, PCB1.sch, PCB2.brd, PCB2.sch]
2019-03-18 19/3 Finally finished PCB everything gerber in here too bye maybe make a 3d model sometime when im free
    [PCB1.brd, PCB1.sch, PCB2.brd, PCB2.sch]
2019-03-24 24/3 Added schematics PDF and addHoles ULP
